yatharth1011/aegis-rescue-rover/team_share/engineering/AEGIS_Design_Calculations.md

# A.E.G.I.S. Design Calculations

Generated by `aegis_design_calcs.py`. Do not edit by hand. Change the inputs in the script and re-run it.

Source tags: **[L]** Robu.in listing (23-Oct-2026), **[D]** datasheet, **[G]** Fusion model geometry, **[A]** stated assumption.

## 1. Mass budget

| Item | Qty | g each | g total | Src |
|---|---:|---:|---:|---|
| Acrylic chassis plate 170x110x3 | 2 | 65.4 | 130.7 | G |
| PLA gripper base | 1 | 24.9 | 24.9 | G |
| PLA jaw (hub + arm) | 2 | 12.9 | 25.7 | G |
| N20 gearmotor with encoder | 4 | 11.0 | 44.0 | L |
| 44 mm wheel | 4 | 9.0 | 36.0 | A |
| MG946R servo | 1 | 65.0 | 65.0 | L |
| 3S1P 18650 pack incl. BMS, wrap, leads | 1 | 163.0 | 163.0 | A |
| ESP32-S3 DevKitC | 1 | 10.0 | 10.0 | A |
| ESP32-CAM + OV2640 | 1 | 10.0 | 10.0 | A |
| TB6612FNG module | 2 | 3.0 | 6.0 | A |
| XL4015 module with heatsink | 2 | 22.0 | 44.0 | A |
| MPU-6050 / INMP441 x2 / VL53L0X x3 | 1 | 13.0 | 13.0 | A |
| M3 pillars (20 F-F + 10 M-F) per corner | 4 | 4.5 | 18.0 | A |
| M3 screws, nuts | 1 | 20.0 | 20.0 | A |
| Wiring harness, perfboard, connectors | 1 | 60.0 | 60.0 | A |
| **Dry sum** | | | **670** | |
| Contingency 15 % | | | 101 | A |
| Design payload | | | 200 | A |
| **Design mass m** | | | **971** | |

## 2. Drive torque and traction

Per-wheel output torque, straight line:

$$\tau_{wheel} = \frac{r}{4}\left(C_{rr}\,m g\cos\theta + m a + m g\sin\theta\right)$$

Two corrections to the formula in the hand-off note:

- It used the traction coefficient μ as a resistive force. μ is the grip limit, not a drag. The drag term is rolling resistance $C_{rr}$. μ is used below only to check for wheel slip.
- It divided by a gearbox efficiency η. The listed motor torques are already measured at the gearbox output and the wheel is mounted directly on the shaft, so no extra η applies.

Skid-steer pivot turn: each wheel scrubs sideways at $\mu_{lat}\,mg/4$ with lever arm L/2. The four drive forces act at B/2:

$$F_{wheel} = \frac{\mu_{lat}\, m g\, L}{4B}, \qquad \tau_{wheel} = F_{wheel}\, r$$

| Input | Value | Src |
|---|---|---|
| Wheel radius r | 22.0 mm | G |
| Wheelbase L / track B | 110 / 132 mm | G |
| C_rr / μ traction / μ lateral | 0.05 / 0.8 / 0.6 | A |
| Design accel / incline | 0.5 m/s² / 15° | A |
| N20 rated torque (continuous limit) | 1.0 kg·cm = 0.0981 N·m @ 160 rpm | L |
| N20 stall: listed / derated | 7.0 / 2.8 kg·cm, 1.0 A | L / A |

| Load case | Total force | τ per wheel | % of rated | Check |
|---|---:|---:|---:|---|
| Cruise, flat, constant speed | 0.48 N | 0.027 kg·cm | 3 % | PASS |
| Accelerate 0.5 m/s² up 15° ramp | 3.41 N | 0.191 kg·cm | 19 % | PASS |
| Pivot turn in place | 1.19 N per wheel | 0.267 kg·cm | 27 % | PASS |

- Traction available per wheel: μ·mg/4 = 1.91 N. The worst drive force is 1.19 N per wheel, so the wheels grip and do not slip (PASS).
- The steepest climbable slope is set by traction, not torque: atan(μ) = 39°.
- Speed at rated load: 0.37 m/s. Pivot turning is the hardest drive case, at 1.4× the torque of the ramp case.

## 3. Electrical budget

Power architecture: the 3S pack (10.5–12.6 V) feeds both TB6612FNG drivers directly (VM max 15 V [D]). Two XL4015 bucks make separate 5.0 V rails: **Rail A** for logic and **Rail B** for the servo. The servo gets its own rail so its stall-current dips cannot trip the ESP32 brown-out reset.

### 3.1 Rail A, 5.0 V logic

| Load | Avg A | Peak A | Src |
|---|---:|---:|---|
| ESP32-S3 (Wi-Fi active, 240 MHz dual core) | 0.120 | 0.340 | D: ESP32-S3 TX peak ~340 mA |
| ESP32-CAM streaming OV2640 | 0.180 | 0.310 | A: ESP32 TX peak + camera |
| VL53L0X x3 (continuous ranging) | 0.057 | 0.057 | D: 19 mA active |
| MPU-6050 | 0.004 | 0.004 | D: 3.9 mA |
| INMP441 x2 | 0.003 | 0.003 | D: 1.4 mA |
| N20 Hall encoders x4 | 0.040 | 0.040 | A |
| TB6612FNG logic x2 | 0.004 | 0.004 | D |
| Module power LEDs (~6) | 0.030 | 0.030 | A |
| **Total** | **0.438** | **0.788** | |

XL4015 is rated 5 A. Rail A peaks at 16 % of that.

### 3.2 Rail B, 5.0 V servo

MG946R stall is listed at 1.2 A [L]. The rail is sized for 2.5 A [A], because MG99x-class servos commonly measure 2–2.5 A at stall. Measure the real value on a bench supply before trusting either number. The servo is run at 5.0 V, not 6 V, so its stall torque (10.9 kg·cm) keeps the printed gear above SF 2.5 (section 4).

### 3.3 Battery: worst case

Everything stalled at once, battery at 10.5 V loaded:

| Load | Battery-side A |
|---|---:|
| Motors 4 x stall | 4.00 |
| Servo stall (via buck) | 1.40 |
| Logic peak (via buck) | 0.44 |
| **Total** | **5.84** |

- C-rate: 5.84 A / 2.2 Ah = **2.66 C**, against the pack's 10 C rating (PASS).
- A 2C pack (the 999-rupee 2200 mAh INR option) has a 4.4 A limit and would **fail** this case. That is why the BOM uses the 10C ISR pack.
- The pack's BMS continuous rating is not on the listing. It must be ≥ 6 A. Check it on arrival.
- TB6612FNG channel: motor stall is 1.05 A at 12.6 V, against 1.2 A continuous per channel (PASS). This works only with **one motor per channel**, which is why the BOM has two drivers.

The hand-off note's figure was 4(0.45) + 1.2 + 0.25 + 0.1 = 3.35 A ("1.52 C, far below 20 C"). It was wrong in four ways:

1. It assumed 0.45 A motor stall. The listing says 1 A.
2. It assumed 1.2 A servo stall, the optimistic listing figure.
3. It added 5 V and 6 V rail currents directly to battery current, without converting through the buck converters.
4. It assumed the pack was rated 20 C. The pack it named is 2C.

### 3.4 Runtime, mission profile

Usable capacity: 2.2 Ah × 80 % = 1.76 Ah.

| Phase | Time share | Battery A (listed stall) | Battery A (derated stall) |
|---|---:|---:|---:|
| Cruise on flat at 0.3 m/s | 45 % | 0.51 | 0.53 |
| Pivot turns (acoustic homing) | 25 % | 0.54 | 0.67 |
| Ramp / obstacle climb 15 deg | 5 % | 0.65 | 0.81 |
| Stopped: listening / scanning | 20 % | 0.31 | 0.31 |
| Gripping | 5 % | 0.50 | 0.50 |
| **Time-weighted average** | | **0.49** | **0.53** |

- Runtime: **3.6 h** with the listed motor stall torque, **3.3 h** with it derated to 40 %.
- Runtime with everything continuously stalled: 18 min.
- Electronics dominate the average draw. The motors are lightly loaded except when pivot-turning.

## 4. Gripper strength (hand calculation, to be confirmed in Fusion Simulation)

Mechanism: the servo spline drives the +Y jaw directly. The −Y jaw pivots on an M3 steel pin. The two jaw hubs mesh as a 1:1 spur pair (module 2, 15 teeth, pitch radius 15 mm, face 10 mm), so each jaw sees the full servo torque.

Material: PLA+ printed flat (XY), allowable yield σ_y = 40 MPa [A]. Required SF ≥ 2.5.

Servo stall torque at 5.0 V: 10.92 kg·cm = 1.071 N·m (interpolated from listed 10.5 kg·cm @ 4.8 V and 13 kg·cm @ 6 V).

| Check | Load | Stress | SF | Result |
|---|---:|---:|---:|---|
| Jaw arm bending at hub, spec pinch | 10.0 N tip | 4.1 MPa | 9.8 | PASS |
| Jaw arm bending at hub, servo stall | 21.4 N tip | 8.8 MPa | 4.6 | PASS |
| Gear tooth (Lewis), servo stall | 71.4 N tangential | 12.3 MPa | 3.25 | PASS |
| Pivot bore bearing on PLA | 74.5 N | 2.5 MPa | 16.1 | PASS |

- Arm bending: σ = M/Z, with M = F·(L − r_hub) and Z = h·b²/6 (b = 8 mm in the bending direction, h = 8 mm).
- The **gear teeth are the critical feature**, not the jaw arm. A first layout used a 12-tooth, 12 mm-radius gear with the servo at 6 V. It gave σ = 18.4 MPa, SF = 2.18, a **fail**. The fix was to grow the pitch radius to 15 mm (15 teeth) and run the servo at 5.0 V.
- 15 teeth at 20° pressure angle is just under the 17-tooth undercut limit. Generate the teeth with Fusion's SpurGear add-in at 25° pressure angle, or with +0.1 profile shift.
- The torque needed for the 10 N spec pinch is 0.50 N·m, 47 % of stall. **Firmware must stop commanding the servo at the contact angle.** Commanding past contact stalls the servo continuously and heats it.

## 5. Fusion Simulation setup for the jaw (FEA)

Run this after `Build_AEGIS_Rover.py` and after cutting the real gear teeth.

1. **Simulation workspace → New Study → Static Stress.** Simplify: keep only the `Gripper_Jaw_PLA` body; remove or suppress everything else.
2. **Material:** Study Materials → PLA. If the library has no PLA, create a custom material: E = 3.5 GPa, ν = 0.36, ρ = 1.24 g/cm³, **yield = 40 MPa**, ultimate = 45 MPa.
3. **Constraints:**
   - Pin constraint on the 3.2 mm pivot bore (radial + axial fixed, tangential free).
   - Fixed constraint on the flank of one gear tooth at the pitch line. This reacts the drive torque the way the meshing tooth does.
4. **Loads:**
   - Case A: 10 N on the fingertip face, normal to it, pinching inward.
   - Case B: 21.4 N, the servo stall case.
5. **Mesh:** global 5 % of model size. Local mesh control 0.5 mm on the hub-to-arm junction and on the loaded tooth root. Enable adaptive refinement (3 passes).
6. **Pass criteria:**
   - Minimum safety factor (von Mises vs yield) ≥ 2.5 in both cases.
   - Peak stress in case B should be within about 30 % of the hand calculation: arm 8.8 MPa, tooth root 12.3 MPa.
   - If FEA is much higher at the hub-arm corner, add a 2 mm fillet there.
7. **Record for the report:** the safety-factor plot, the von Mises plot, the displacement at the fingertip, and the mesh convergence plot.
