yatharth1011/aegis-rescue-rover/.agents/rules/aegis-read-first.md

---
trigger: always_on
---

Before doing anything in this workspace, read `AGENTS.md` at the project root and follow it. It is mandatory.
Then read the matching skill in `.agents/skills/` for the task: firmware, brain/simulation, PDF guides, CAD/fabrication, office documents, or git.
Ask the user before any design change, deletion, history rewrite, or edit to the course submission files.
