yatharth1011/aegis-rescue-rover/team_share/edge/AEGIS_start_pad.pdf

rover outline (Mk2, 263 x 140 mm)

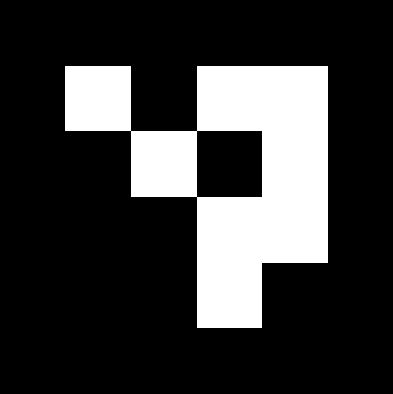
[picture p3: figure]

## FORWARD

100 mm: check with a ruler after printing

## A.E.G.I.S. start pad | ArUco DICT_4X4_50 id 0, 100 mm | print at 100 % (actual size)

Marker centre = --start x, y. Arrow = --start heading.
