yatharth1011/aegis-rescue-rover/FINAL/5_cad_model/render_iso_door_open.png

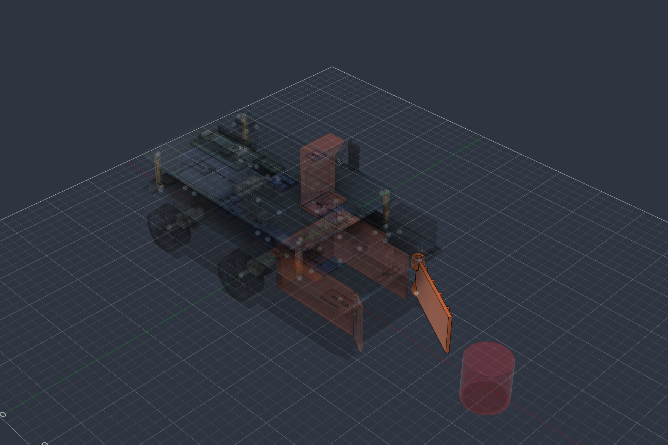
FINAL/5_cad_model/render_iso_door_open.png
