yatharth1011/aegis-rescue-rover/team_share/aegis_rl_training_curve.png

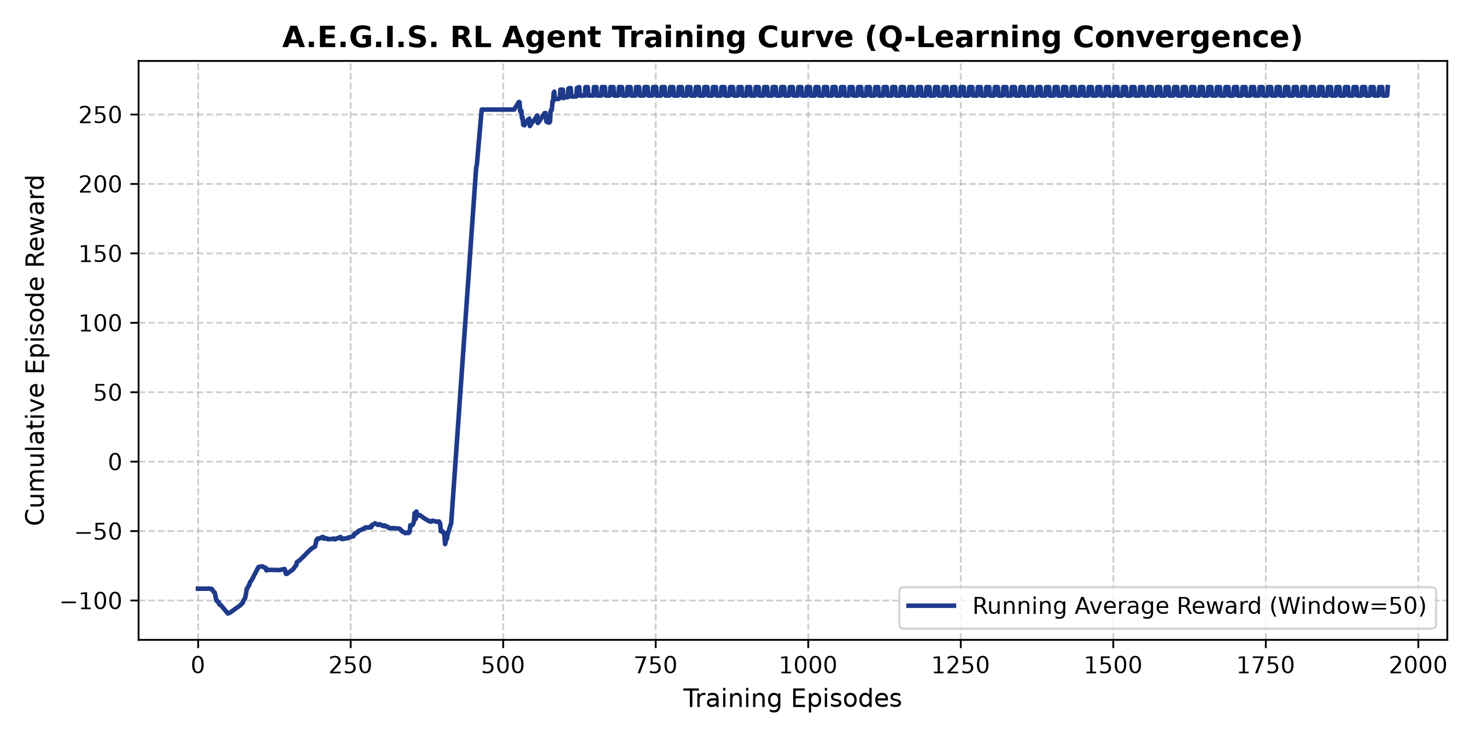
team_share/aegis_rl_training_curve.png
