yatharth1011/aegis-rescue-rover/team_share/deck_assets/ai_sees.png

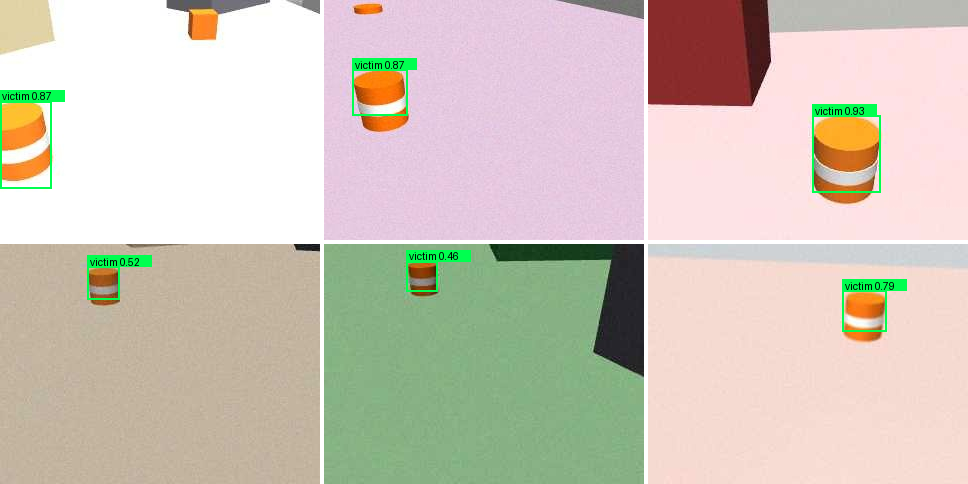
team_share/deck_assets/ai_sees.png
