yatharth1011/aegis-rescue-rover/team_share/deck_assets/demo2_poster.gif

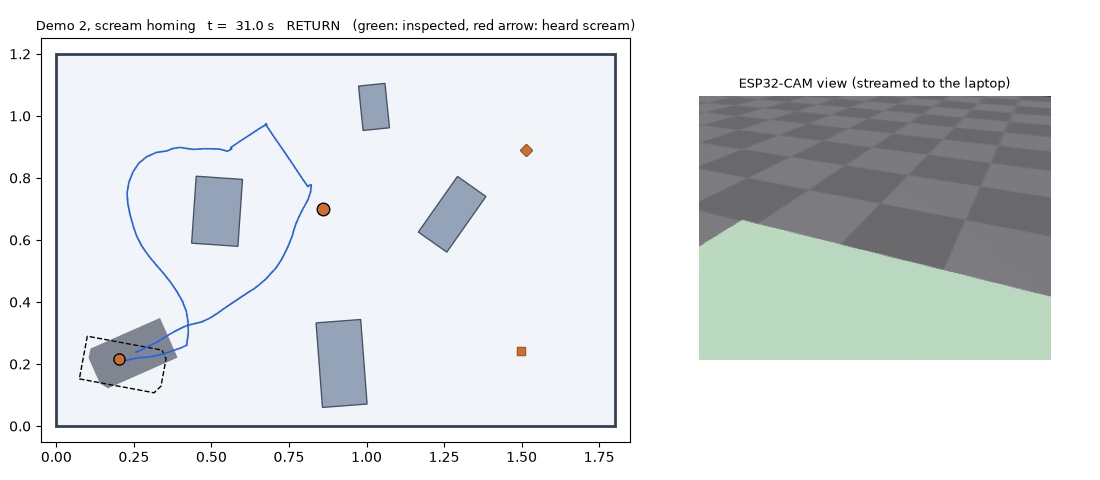
team_share/deck_assets/demo2_poster.gif
