yatharth1011/aegis-rescue-rover/team_share/deck_assets/render_iso_door_closed.png

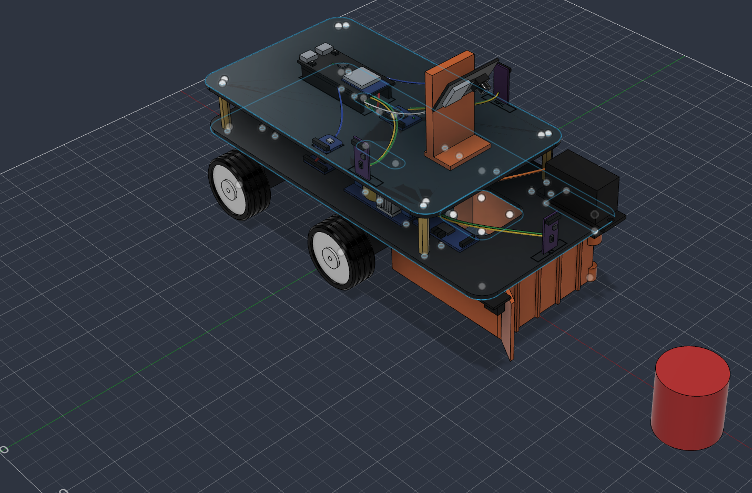
team_share/deck_assets/render_iso_door_closed.png
