yatharth1011/aegis-rescue-rover/team_share/deck_assets/render_iso_rear.png

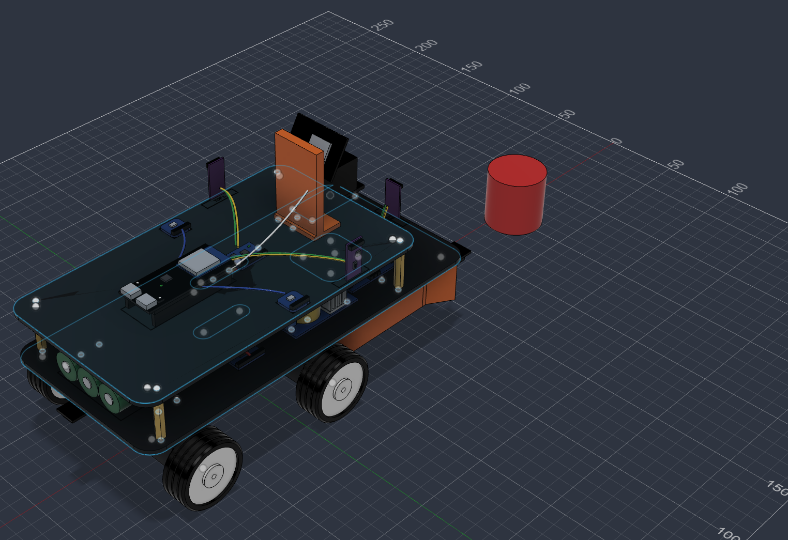
team_share/deck_assets/render_iso_rear.png
