yatharth1011/aegis-rescue-rover/team_share/deck_assets/render_side.png

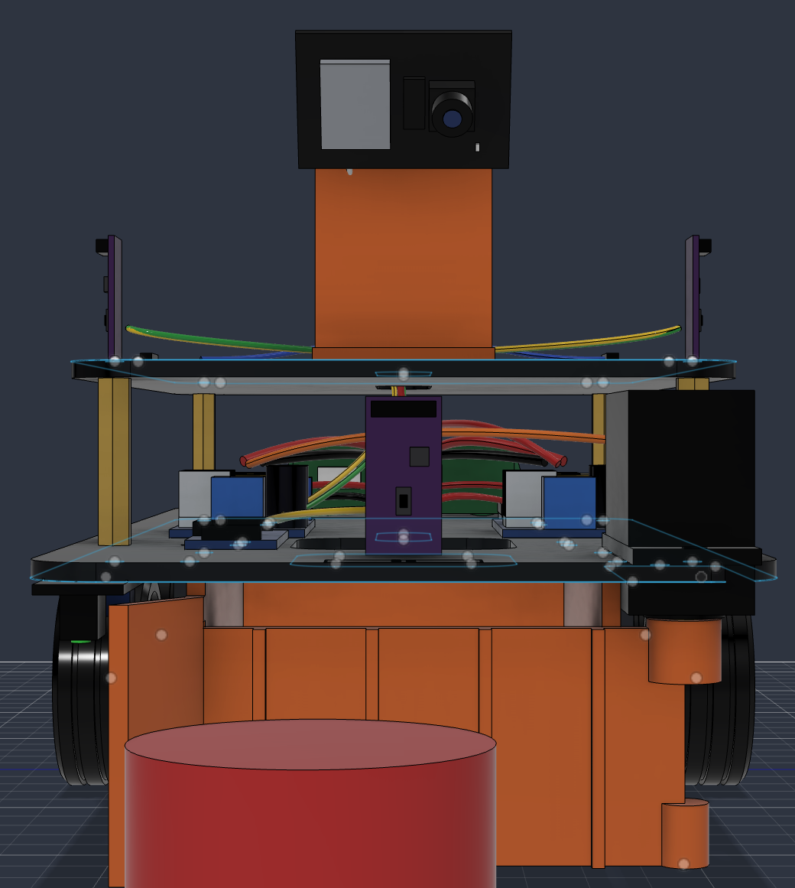
team_share/deck_assets/render_side.png
