yatharth1011/aegis-rescue-rover/FINAL/3_3d_print_K1_Max/AEGIS_plate1_black_PLA+_rover_parts.3mf

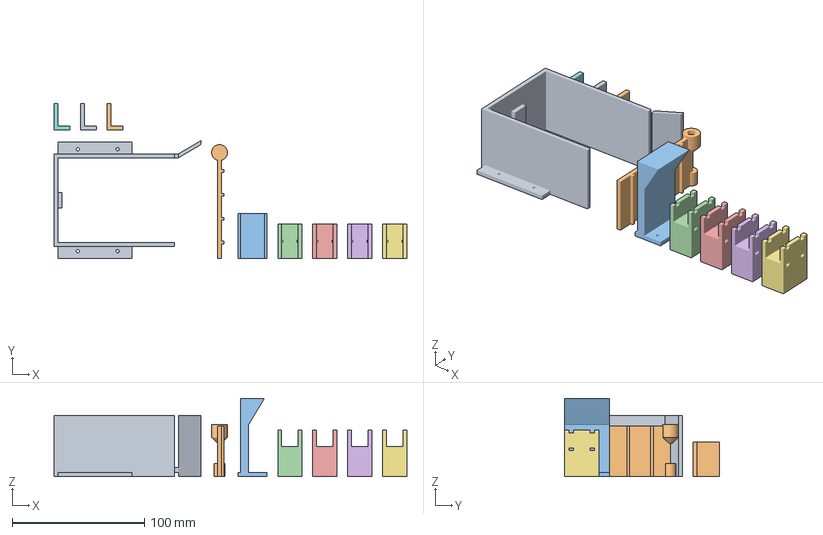
[picture p14: CAD file, 2026-10-26]
FINAL/3_3d_print_K1_Max/AEGIS_plate1_black_PLA+_rover_parts.3mf
266.6 x 117.0 x 59.0 mm
Intake_Shroud
Intake_Door
Camera_Mast
Motor_Hanger_1
Motor_Hanger_2
Motor_Hanger_3
Motor_Hanger_4
ToF_Bracket_Front
ToF_Bracket_Left
ToF_Bracket_Right
