yatharth1011/aegis-rescue-rover/team_share/Build_AEGIS_Rover/output/lasercad_lower_deck.dxf

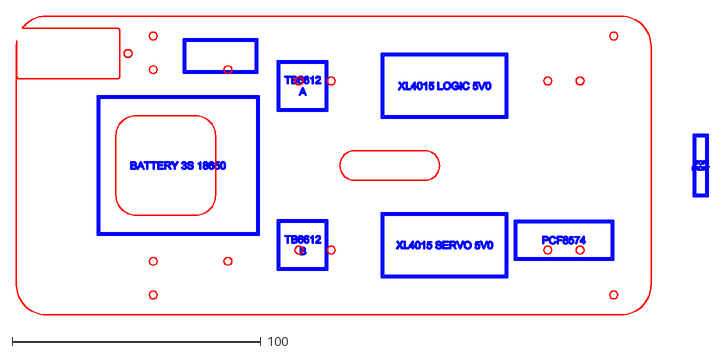
[picture p15: CAD file, 2026-10-25]
team_share/Build_AEGIS_Rover/output/lasercad_lower_deck.dxf
278.5 x 120.0
