yatharth1011/aegis-rescue-rover/team_share/Build_AEGIS_Rover/output_detailed/AEGIS_Rover_Detailed.step

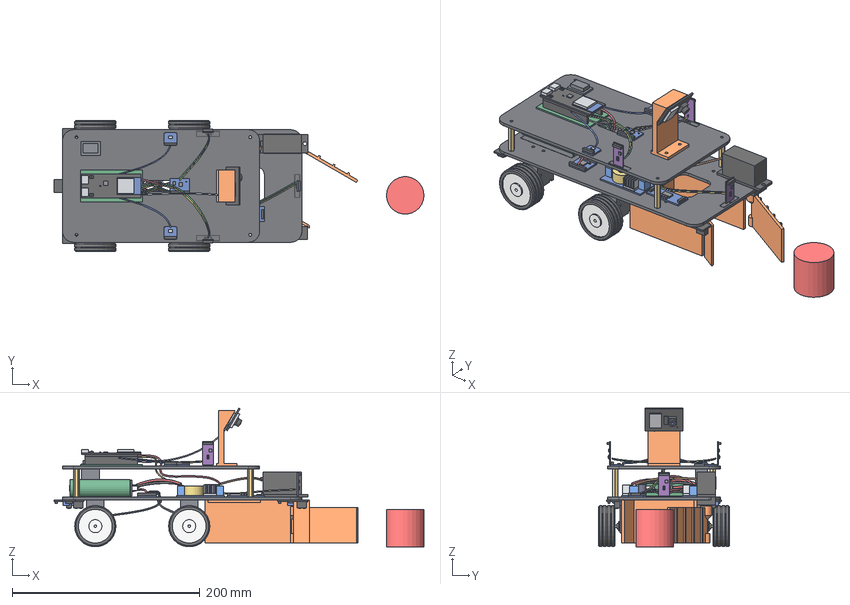
[picture p16: CAD file, 2026-10-25]
team_share/Build_AEGIS_Rover/output_detailed/AEGIS_Rover_Detailed.step
394.0 x 140.0 x 147.7 mm
