yatharth1011/aegis-rescue-rover/team_share/print/Camera_Mast.stl

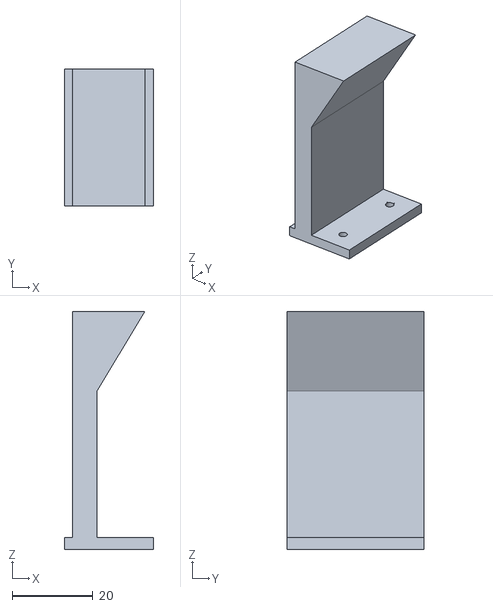
[picture p17: CAD file, 2026-10-26]
team_share/print/Camera_Mast.stl
22.0 x 34.0 x 59.0
