yatharth1011/aegis-rescue-rover/team_share/Build_AEGIS_Rover/output/lasercad_upper_deck.dxf

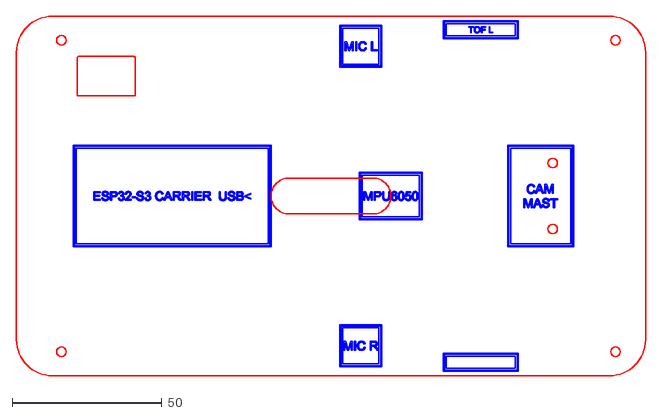
[picture p18: CAD file, 2026-10-25]
team_share/Build_AEGIS_Rover/output/lasercad_upper_deck.dxf
210.0 x 120.0
