yatharth1011/aegis-rescue-rover/team_share/Build_AEGIS_Rover/output_detailed/print_Intake_Door_PLA.stl

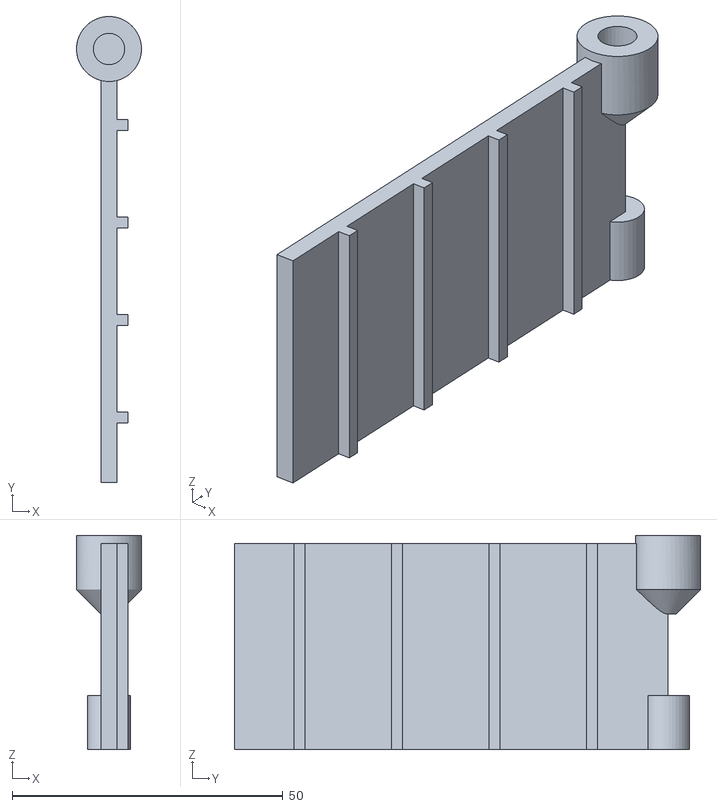
[picture p19: CAD file, 2026-10-25]
team_share/Build_AEGIS_Rover/output_detailed/print_Intake_Door_PLA.stl
12.0 x 86.0 x 39.5
