yatharth1011/aegis-rescue-rover/team_share/print/Intake_Shroud.stl

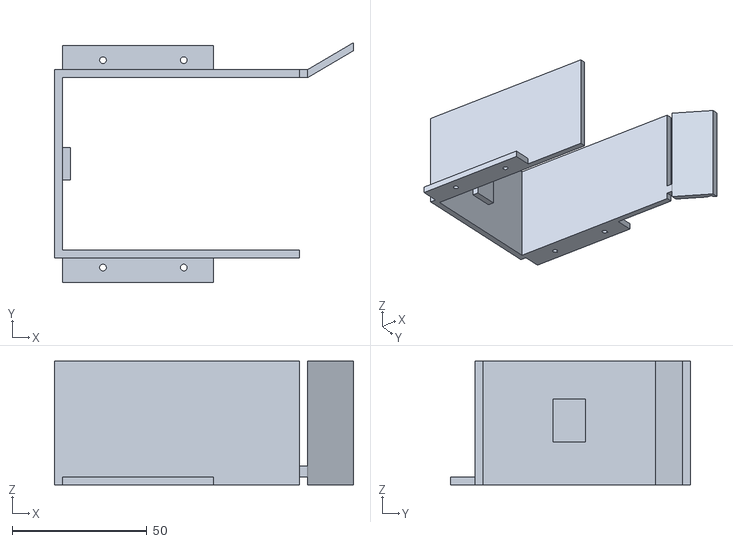
[picture p20: CAD file, 2026-10-26]
team_share/print/Intake_Shroud.stl
111.0 x 89.0 x 46.0
