yatharth1011/aegis-rescue-rover/team_share/Build_AEGIS_Rover/output/lasercad_lower_deck_underside.dxf

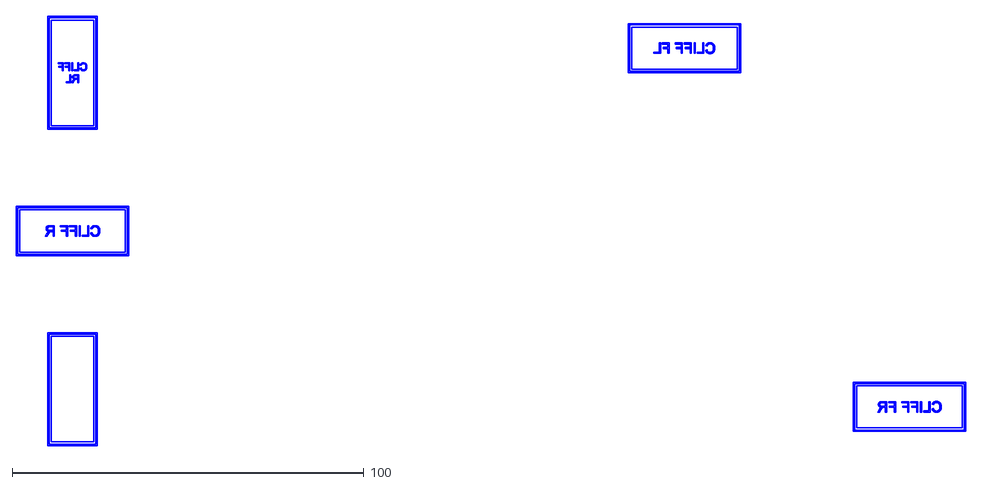
[picture p21: CAD file, 2026-10-25]
team_share/Build_AEGIS_Rover/output/lasercad_lower_deck_underside.dxf
270.0 x 122.0
