yatharth1011/aegis-rescue-rover/team_share/Build_AEGIS_Rover/output_detailed/lasercut_upper_deck.dxf

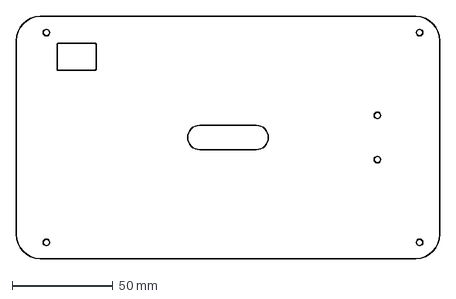
[picture p22: CAD file, 2026-10-25]
team_share/Build_AEGIS_Rover/output_detailed/lasercut_upper_deck.dxf
210.0 x 120.0 mm
