yatharth1011/aegis-rescue-rover/team_share/print/AEGIS_plate2_orange_PLA_demo_props.3mf

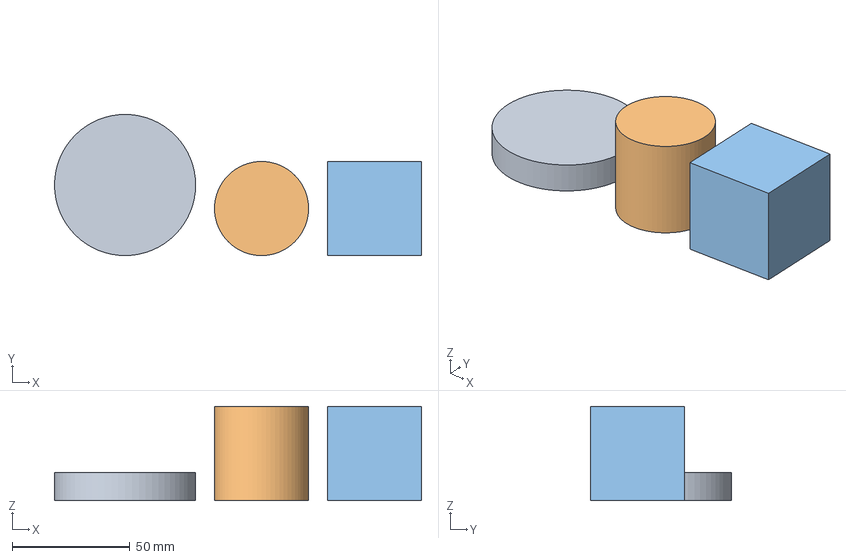
[picture p23: CAD file, 2026-10-26]
team_share/print/AEGIS_plate2_orange_PLA_demo_props.3mf
156.0 x 60.0 x 40.0 mm
Decoy_Disc_60mm
Victim_Token_40mm
Decoy_Cube_40mm
