yatharth1011/aegis-rescue-rover/team_share/Build_AEGIS_Rover/output/AEGIS_Rover.step

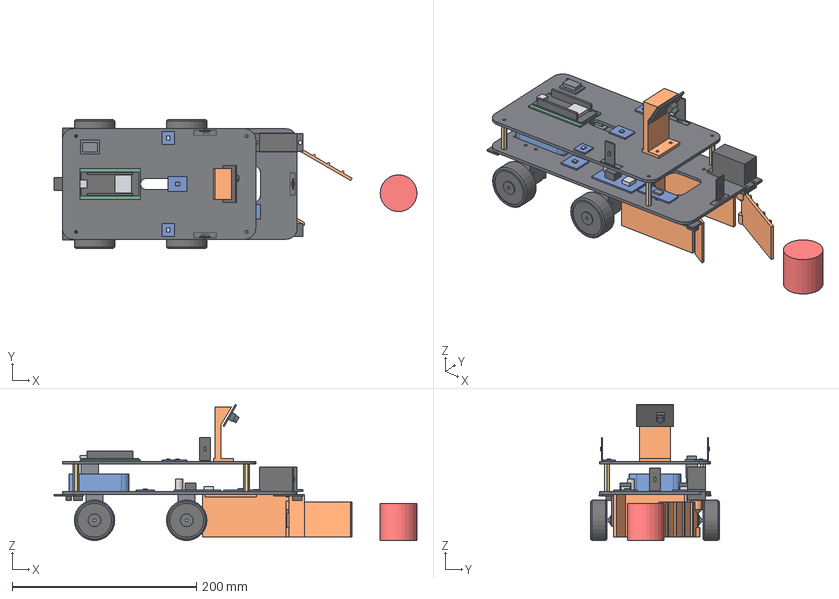
[picture p24: CAD file, 2026-10-25]
team_share/Build_AEGIS_Rover/output/AEGIS_Rover.step
394.0 x 140.0 x 147.7 mm
