yatharth1011/aegis-rescue-rover/team_share/Build_AEGIS_Rover/output_detailed/print_Motor_Hanger_PLA.stl

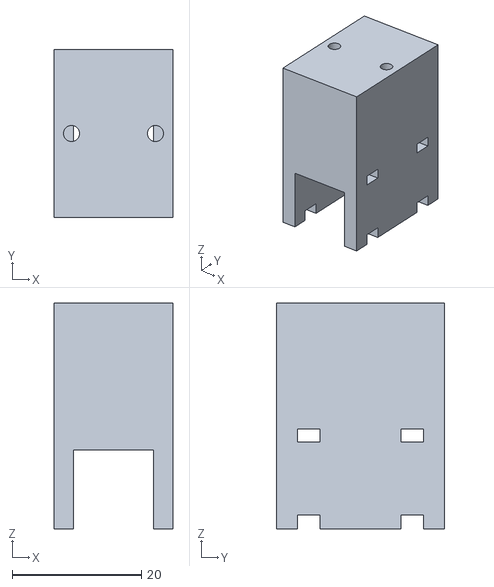
[picture p25: CAD file, 2026-10-25]
team_share/Build_AEGIS_Rover/output_detailed/print_Motor_Hanger_PLA.stl
18.4 x 26.0 x 35.0
