yatharth1011/aegis-rescue-rover/team_share/print/ToF_Bracket_Front.stl

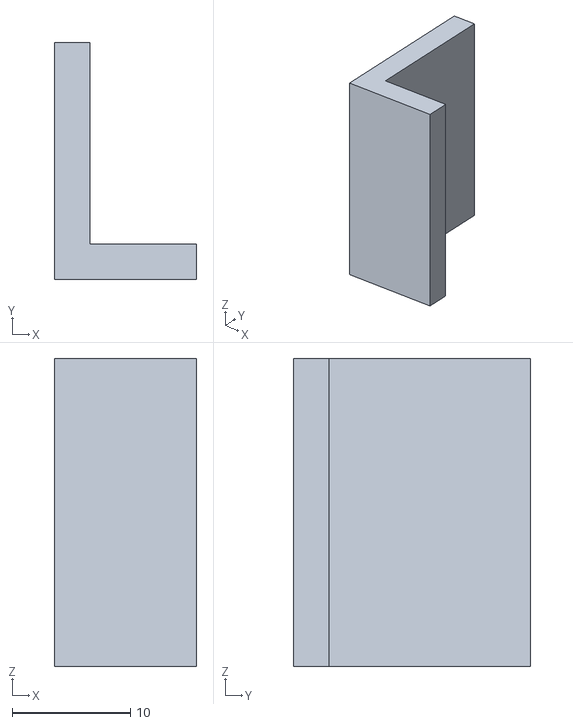
[picture p26: CAD file, 2026-10-25]
team_share/print/ToF_Bracket_Front.stl
12.0 x 20.0 x 26.0
