yatharth1011/aegis-rescue-rover/team_share/Build_AEGIS_Rover/output_detailed/engrave_lower_deck_top_labels.dxf

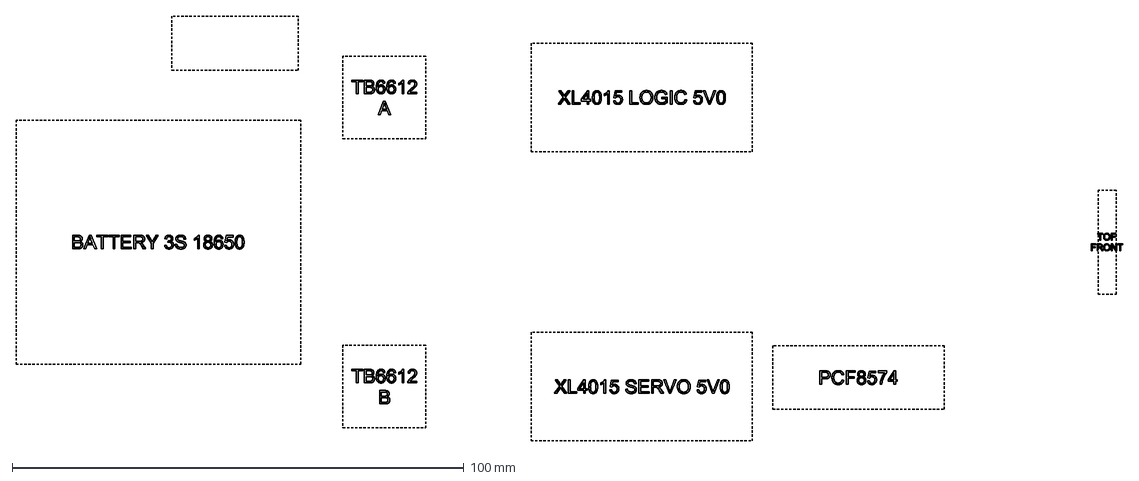
[picture p27: CAD file, 2026-10-25]
team_share/Build_AEGIS_Rover/output_detailed/engrave_lower_deck_top_labels.dxf
245.0 x 94.0 mm
