yatharth1011/aegis-rescue-rover/team_share/Build_AEGIS_Rover/output_detailed/engrave_lower_deck_underside.dxf

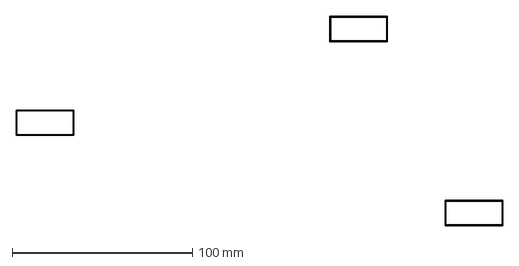
[picture p29: CAD file, 2026-10-24]
team_share/Build_AEGIS_Rover/output_detailed/engrave_lower_deck_underside.dxf
270.0 x 116.0 mm
