yatharth1011/aegis-rescue-rover/team_share/Build_AEGIS_Rover/output/engrave_upper_deck_top.dxf

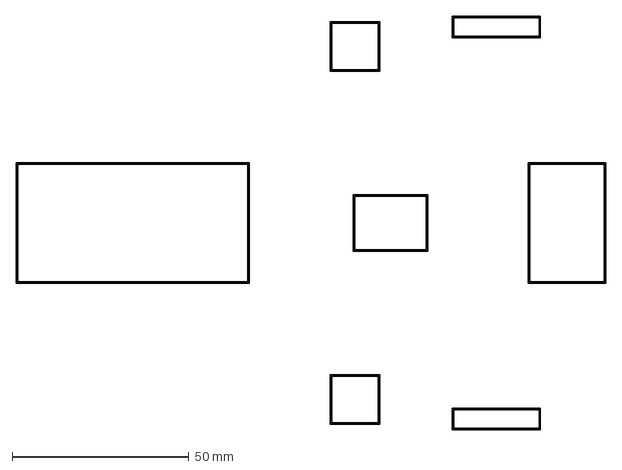
[picture p30: CAD file, 2026-10-25]
team_share/Build_AEGIS_Rover/output/engrave_upper_deck_top.dxf
167.0 x 117.0 mm
