yatharth1011/aegis-rescue-rover/team_share/Build_AEGIS_Rover/output_detailed/print_Camera_Mast_PLA.stl

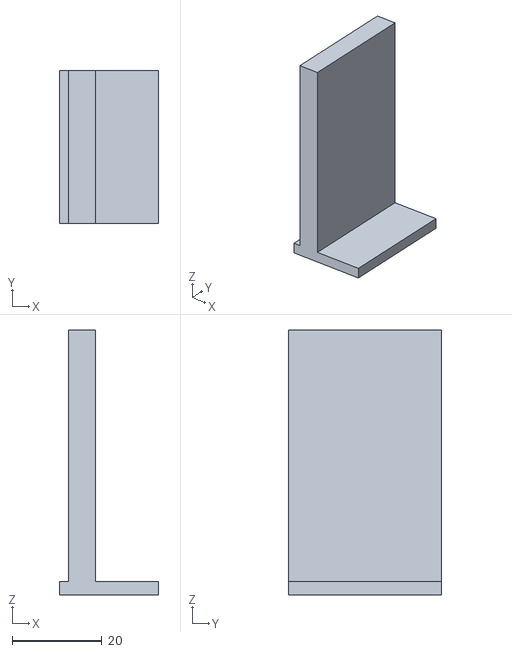
[picture p31: CAD file, 2026-10-24]
team_share/Build_AEGIS_Rover/output_detailed/print_Camera_Mast_PLA.stl
22.0 x 34.0 x 59.0
