yatharth1011/aegis-rescue-rover/team_share/Build_AEGIS_Rover/output/engrave_upper_deck_top_labels.dxf

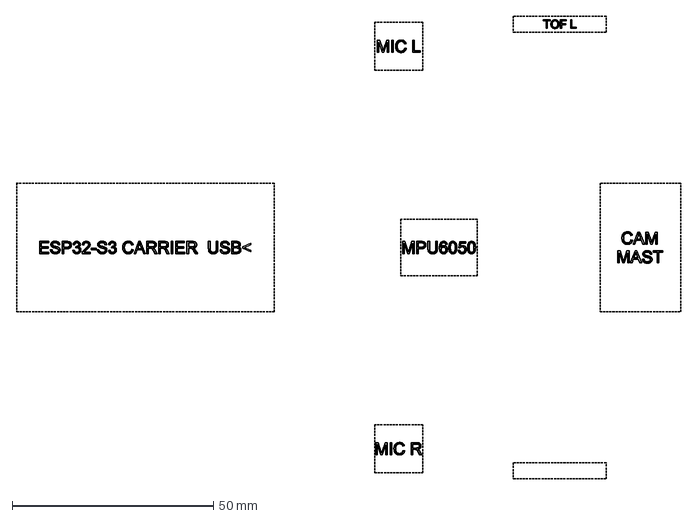
[picture p32: CAD file, 2026-10-25]
team_share/Build_AEGIS_Rover/output/engrave_upper_deck_top_labels.dxf
165.0 x 115.0 mm
