yatharth1011/aegis-rescue-rover/team_share/Build_AEGIS_Rover/output_detailed/engrave_lower_deck_underside_labels.dxf

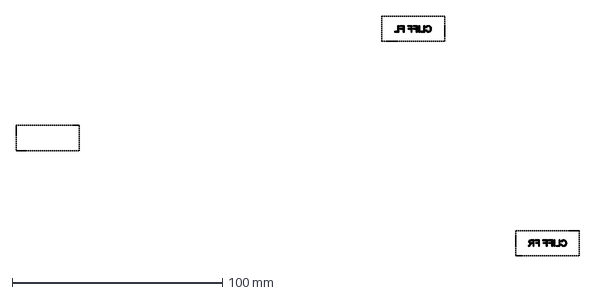
[picture p33: CAD file, 2026-10-24]
team_share/Build_AEGIS_Rover/output_detailed/engrave_lower_deck_underside_labels.dxf
268.0 x 114.0 mm
