yatharth1011/aegis-rescue-rover/team_share/print/AEGIS_PLA_parts.3mf

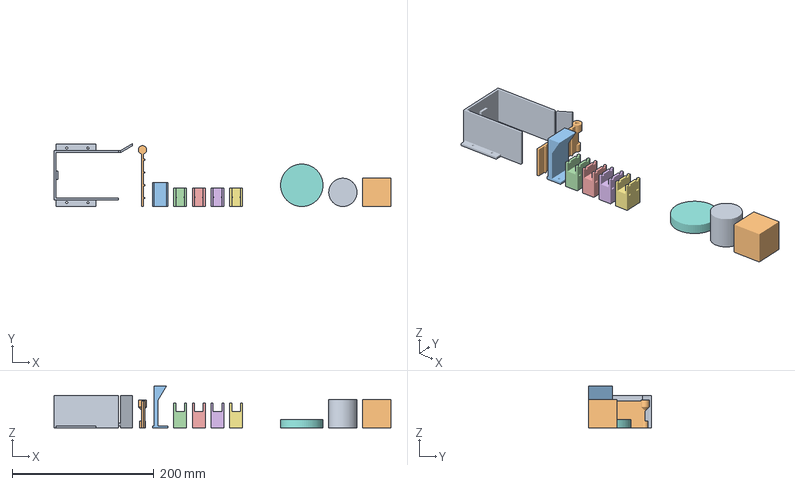
[picture p34: CAD file, 2026-10-25]
team_share/print/AEGIS_PLA_parts.3mf
476.0 x 89.0 x 59.0 mm
Intake_Shroud
Intake_Door
Camera_Mast
Motor_Hanger_1
Motor_Hanger_2
Motor_Hanger_3
Motor_Hanger_4
Decoy_Disc_60mm
Victim_Token_40mm
Decoy_Cube_40mm
