yatharth1011/aegis-rescue-rover/team_share/Build_AEGIS_Rover/output/engrave_lower_deck_top.dxf

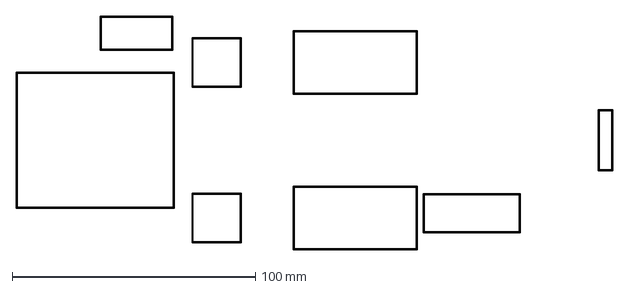
[picture p35: CAD file, 2026-10-25]
team_share/Build_AEGIS_Rover/output/engrave_lower_deck_top.dxf
245.5 x 96.0 mm
