yatharth1011/aegis-rescue-rover/team_share/Build_AEGIS_Rover/output_detailed/engrave_upper_deck_top.dxf

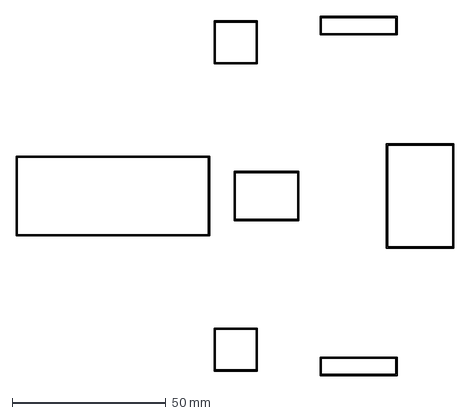
[picture p36: CAD file, 2026-10-24]
team_share/Build_AEGIS_Rover/output_detailed/engrave_upper_deck_top.dxf
142.5 x 117.0 mm
