yatharth1011/aegis-rescue-rover/team_share/print/Decoy_Cube_40mm.stl

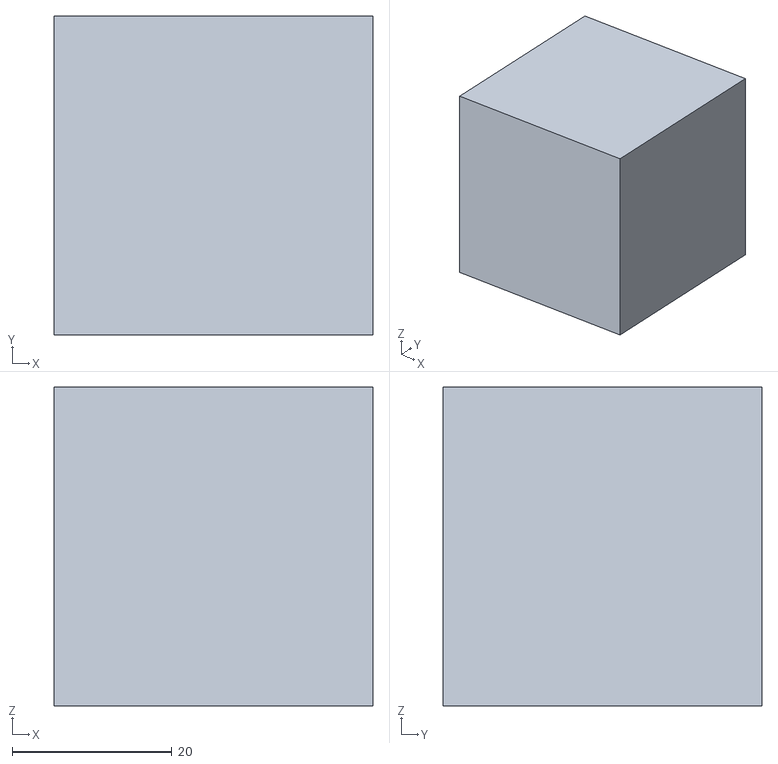
[picture p37: CAD file, 2026-10-25]
team_share/print/Decoy_Cube_40mm.stl
40.0 x 40.0 x 40.0
