yatharth1011/aegis-rescue-rover/team_share/print/Victim_Token_40mm.stl

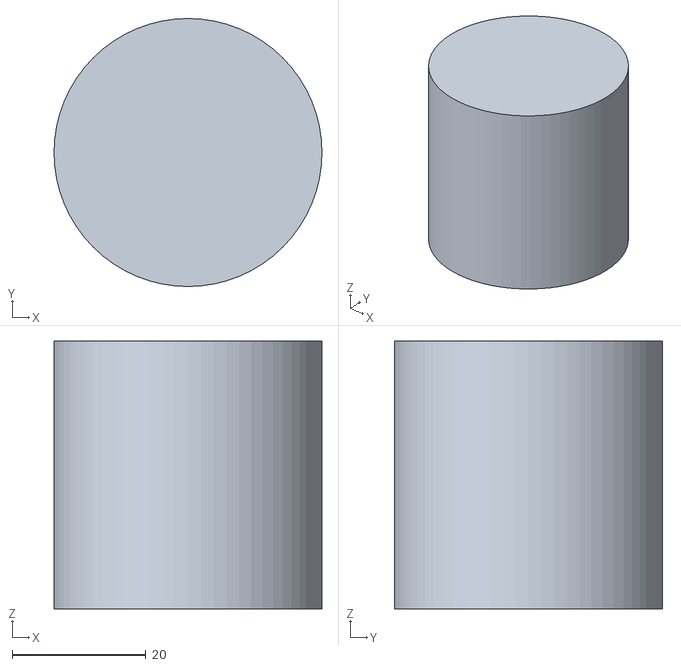
[picture p38: CAD file, 2026-10-25]
team_share/print/Victim_Token_40mm.stl
40.0 x 40.0 x 40.0
