yatharth1011/aegis-rescue-rover/team_share/print/Decoy_Disc_60mm.stl

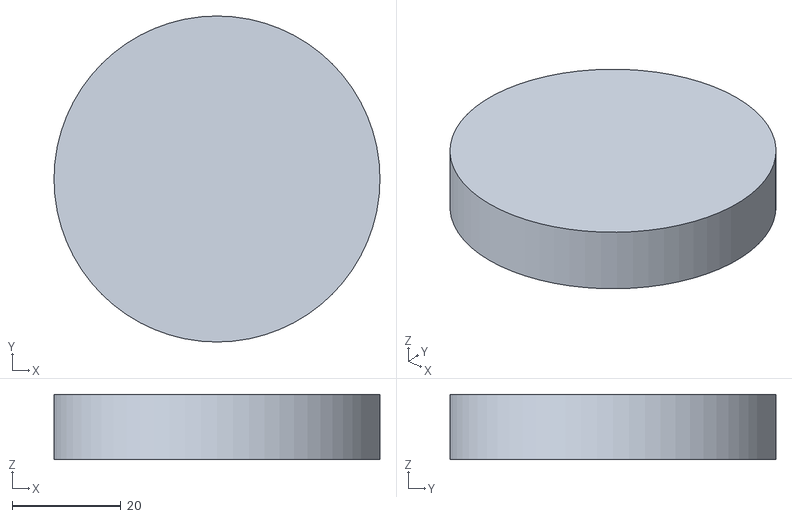
[picture p40: CAD file, 2026-10-25]
team_share/print/Decoy_Disc_60mm.stl
60.0 x 60.0 x 12.0
