yatharth1011/aegis-rescue-rover/team_share/Build_AEGIS_Rover/output/engrave_lower_deck_underside_labels.dxf

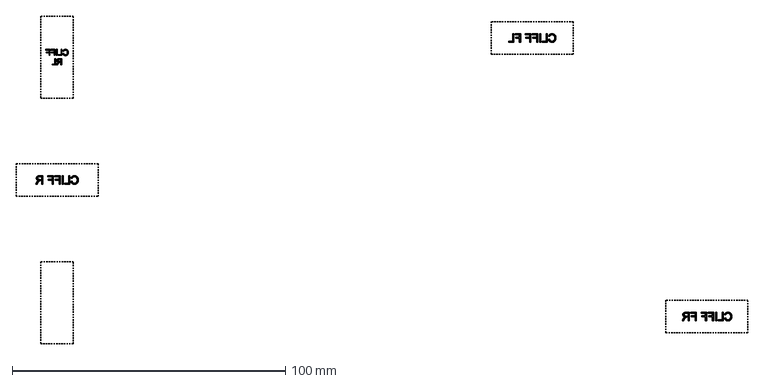
[picture p41: CAD file, 2026-10-24]
team_share/Build_AEGIS_Rover/output/engrave_lower_deck_underside_labels.dxf
268.0 x 120.0 mm
