yatharth1011/aegis-rescue-rover/team_share/Build_AEGIS_Rover/output/engrave_lower_deck_top_labels.dxf

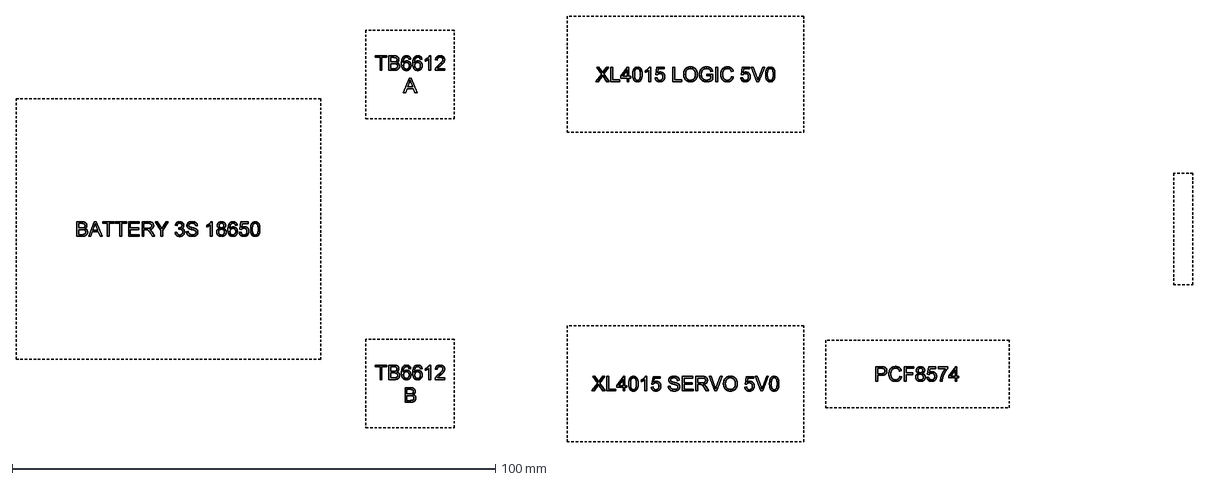
[picture p42: CAD file, 2026-10-24]
team_share/Build_AEGIS_Rover/output/engrave_lower_deck_top_labels.dxf
243.5 x 88.0 mm
