yatharth1011/aegis-rescue-rover/team_share/Build_AEGIS_Rover/output/lasercut_lower_deck.dxf

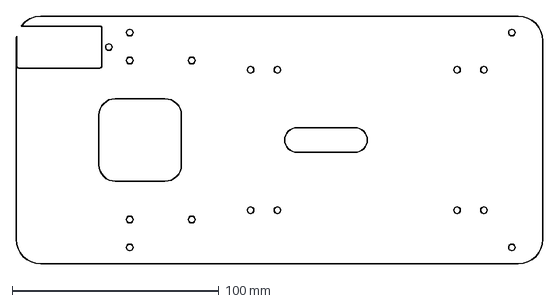
[picture p43: CAD file, 2026-10-24]
team_share/Build_AEGIS_Rover/output/lasercut_lower_deck.dxf
255.0 x 120.0 mm
