yatharth1011/aegis-rescue-rover/team_share/Build_AEGIS_Rover/output/print_Motor_Hanger_PLA.stl

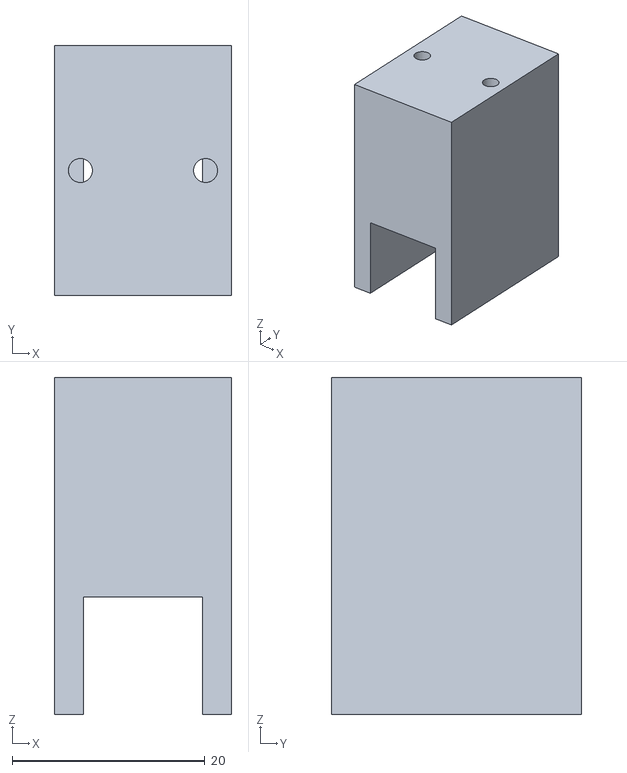
[picture p44: CAD file, 2026-10-24]
team_share/Build_AEGIS_Rover/output/print_Motor_Hanger_PLA.stl
18.4 x 26.0 x 35.0
