yatharth1011/aegis-rescue-rover/(list of files, cad)

Other CAD files:
team_share/Build_AEGIS_Rover/output/print_Intake_Shroud_PLA.stl
team_share/print/AEGIS_plate1_black_PLA+_rover_parts.3mf
team_share/print/Intake_Door.stl
team_share/print/Motor_Hanger_3.stl
team_share/Build_AEGIS_Rover/output/print_Camera_Mast_PLA.stl
AEGIS Body.f3d
AEGIS Detailed Final.f3d
AEGIS Detailed.f3d
AEGIS Final.f3d
FINAL/5_cad_model/AEGIS_Rover.f3d
FINAL/5_cad_model/AEGIS_Rover_Detailed.f3d
The Most Final AEGIS Body Detailed.f3d
The Most Final AEGIS Body.f3d
team_share/Build_AEGIS_Rover/output/AEGIS_Rover.f3d
team_share/Build_AEGIS_Rover/output_detailed/AEGIS_Rover_Detailed.f3d
