yatharth1011/aegis-rescue-rover/team_share/AEGIS_Wiring_Guide.pdf

## A.E.G.I.S. wiring guide 1/3: ESP32-S3-DevKitC-1 pin assignment (top view, antenna up)

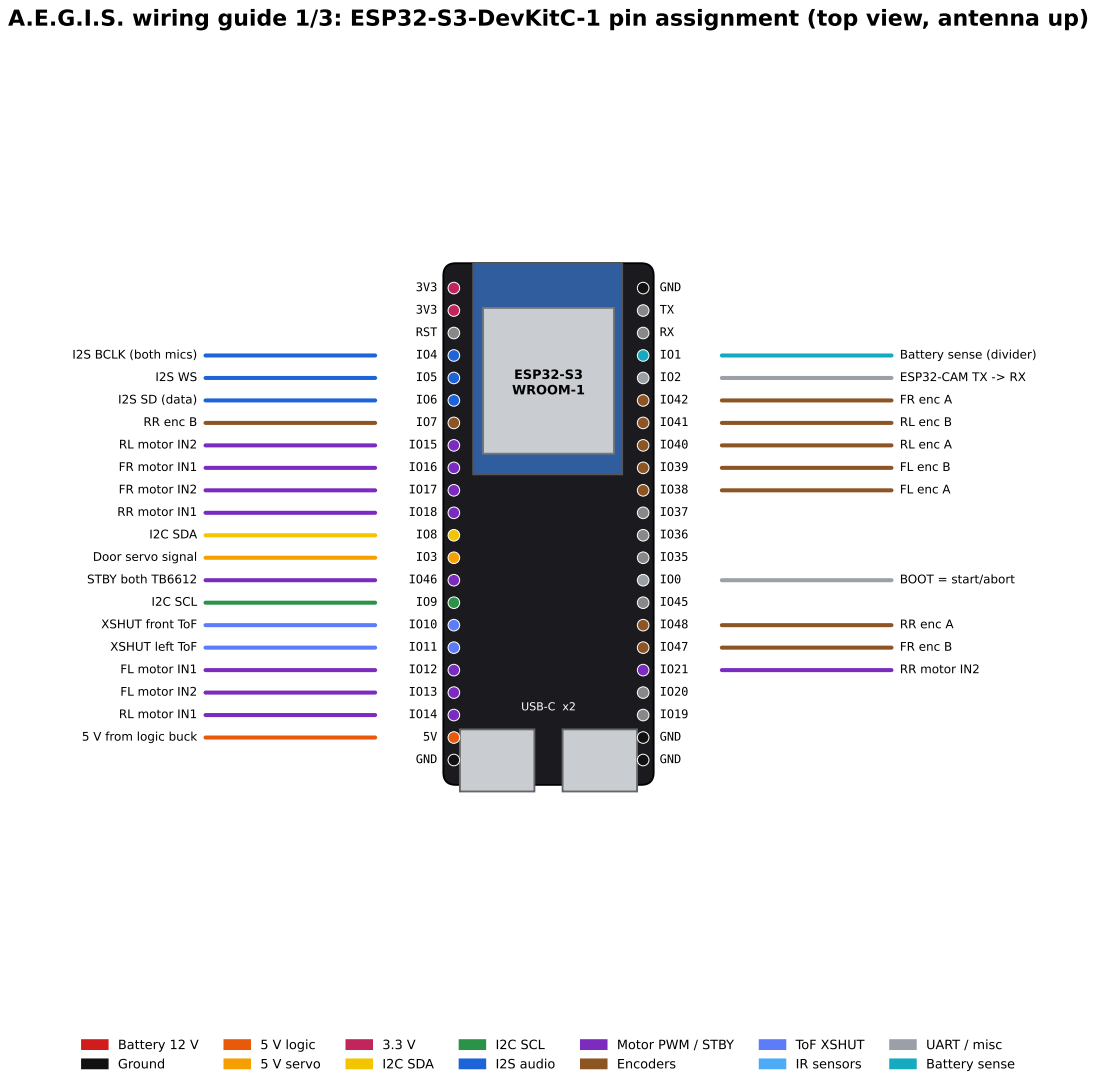
[picture p83: page 1]
ESP32-S3 WROOM-1; USB-C x2; 3V3 3V3 RST; I2S BCLK (both mics); I2S SD (data); RR enc B; RL motor IN2; FR motor IN1; FR motor IN2; RR motor IN1; I2C SDA; Door servo signal; STBY both TB6612; I2C SCL; XSHUT front ToF; XSHUT left ToF; FL motor IN1; FL motor IN2; RL motor IN1; 5 V from logic buck; GND; GND TX RX; Battery sense (divider); ESP32-CAM TX -> RX; FR enc A; RL enc B; RL enc A; FL enc B; FL enc A; BOOT = start/abort; RR enc A; FR enc B; RR motor IN2; IO20 IO19 GND GND; Battery 12 V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

Motor PWM / STBY
Encoders

20.3 x 20.3 mm Battery + ⁽¹⁰.5⁻12.6 V⁾ VM 3V3 VCC GND GND front motor + AO¹ front motor ⁻ AO² rear motor ⁻ BO² rear motor + BO¹ GND GND PWMA tie to 3V3 AIN² IN² ⁽GPIO ¹³/17⁾ AIN¹ IN¹ ⁽GPIO ¹²/16⁾ STBY GPIO ⁴⁶ BIN¹ IN¹ ⁽GPIO ¹⁴/18⁾ BIN² IN² ⁽GPIO ¹⁵/21⁾ PWMB tie to 3V3 GND GND

TB6612FNG (x2: A = left wheels, B = right)

Battery + IN+

Battery - IN- | 51 x 26 mm | OUT+ 5.0 V out (set BEFORE load) OUT- GND

XL4015 buck (x2: logic 5.0 V, servo 5.0 V)

25 x 12 mm

3V3 VIN
GND GND
I2C SCL SCL
I2C SDA SDA
not used GPIO1
GPIO 10 / 11 / tie high (right) XSHUT

GY-530 VL53L0X (x3: front, left, right)

# 21 x 16 mm 3V3 VCC GND GND I2C SCL SCL I2C SDA SDA - XDA - XCL GND ⁽addr 0x68⁾ AD⁰ - INT

GY-521 MPU-6050

# 14 x 14 mm L: GND / R: 3V3 L/R GPIO ⁵ WS GPIO ⁴ SCK GPIO ⁶ SD 3V3 VDD GND GND

INMP441 mic (x2)

40 x 16 mm

GND GND
3V3 VCC
I2C SDA SDA
I2C SCL SCL

## cliff FL P0

## cliff FR P1 cliff rear P2

## cliff RL P3

## cliff RR P4

bay capture P5

PCF8574T I/O expander

32 x 14 mm

3V3 VCC
GND GND
PCF8574 P0-P5 DO

TCRT5000 x5 / IR obstacle module x1

40.7 x 19.7 mm

GND brown
servo buck 5.0 V red
GPIO 3 orange

red M+ to AO1/BO1
white M- to AO2/BO2
black encoder VCC 3V3
blue encoder GND
yellow enc A
green enc B
MG946R servo | N20 encoder motor (x4)

A.E.G.I.S. wiring guide 2/3: module faces, pins and where each wire lands (top views, to scale)

Battery 12 V
Ground

5 V logic
5 V servo

3.3 V
I2C SDA

I2C SCL
I2S audio

Motor PWM / STBY
Encoders

ToF XSHUT
IR sensors

UART / misc
Battery sense

From | To | Signal | Wire
Battery + (T-connector lead) | 6.3 A fuse, power switch, then both XL4015 IN+ and both TB6612 VM | 10.5-12.6 V | 18 AWG
Battery - | Both XL4015 IN-, all GND | 0 V | 18 AWG
XL4015 logic OUT+ | ESP32-S3 5V, ESP32-CAM 5V | 5.0 V | 22 AWG
XL4015 servo OUT+ | MG946R red | 5.0 V | 22 AWG
ESP32-S3 3V3 | sensors VCC, TB6612 VCC + PWMA/PWMB, encoders | 3.3 V | 26 AWG
ESP32 GPIO 8 / 9 | VL53L0X x3, MPU-6050, PCF8574 (SDA/SCL), 2.2 k pull-ups | I2C 400 kHz | 26 AWG
ESP32 GPIO 4 / 5 / 6 | both INMP441 SCK / WS / SD | I2S 48 kHz | 26 AWG, short
ESP32 GPIO 10 / 11 | front / left VL53L0X XSHUT (right: tie to VIN) | address select | 26 AWG
ESP32 GPIO 12-18, 21 | TB6612 AIN1/AIN2/BIN1/BIN2 | 20 kHz PWM | 26 AWG
ESP32 GPIO 46 | STBY on both TB6612 | enable | 26 AWG
TB6612 AO1/AO2/BO1/BO2 | motor red / white | motor power | 22 AWG
Encoders yellow / green | GPIO 38/39, 40/41, 42/47, 48/7 | quadrature | 26 AWG
ESP32 GPIO 3 | MG946R orange | 50 Hz servo pulse | 26 AWG
ESP32-CAM U0T | ESP32 GPIO 2 | UART 115200 | 26 AWG
Battery + via 100k / 20k | ESP32 GPIO 1 (divider tapped after the switch) | battery voltage | 26 AWG
IR modules DO | PCF8574 P0-P5 | 5 cliff + bay capture | 26 AWG

The fuse and the power switch sit in the battery + line before anything else. The 2.2 k pull-ups and the battery divider are on the ESP32-S3 carrier board.
Common ground star point at the battery negative. Set both XL4015 outputs to 5.0 V with a meter before connecting any board. Twist each motor's two leads together. Keep the I2S wires short (< 15 cm).
Header orders follow the reference boards; clone modules sometimes differ: check the silkscreen before soldering.

## A.E.G.I.S. wiring guide 3/3: wire list
