yatharth1011/aegis-rescue-rover/FINAL/4_guides/AEGIS_Wiring_Guide.pdf

## A . E . G . I . S . M K 2

# Wiring guide

## 15 steps, each with its own drawing and a check. Wire as you assemble, in this order:

Solder headers on the modules, build the ESP32-S3 carrier, the fuse board, the switch leads and the power bus (W1-W3). Easier

ASSEMBLY 1-15 | Motors, wheels, edge sensors, intake bay, battery, lower-deck boards (Assembly guide).
STEP 16: WIRE | Lower deck: power, set 5.0 V, motors, servo power, IR sensors, then label the leads for the upper deck (W4-W9).
ASSEMBLY 17-23 | Pillars, upper deck, switch, carrier with the ESP32-S3 removed, gyro, mics, side sensors.
STEP 24: WIRE | Upper deck: power, I2C, microphones, motor control, encoders and servo signal (W10-W14).
POWER-UP | First power-up checks (W15), then assembly 25-27 and the Deployment guide.

A.E.G.I.S. Mk2 | Wiring guide | page 2 of 20

# Rules for every wire

1. Battery unplugged whenever you solder or move a wire.

## 2. Cut each wire 3 cm longer than the route, strip 5 mm, twist the strands, tin

them.
3. Slide heat-shrink on before soldering; shrink it over every power joint.
4. Tug test: pull each finished joint gently. It must not move.

## 5. Red = plus, black = ground, always. Signal wires: white or green, flagged with

masking tape.
6. One row of the table at a time; tick it off on a printed copy.
7. Never connect a regulator output before it reads 5.0 V (W5).
Wire | Use
18 AWG red / black | battery, fuse, switch, power bus, regulator and driver inputs
22 AWG 3-core | 5 V outputs, servo power, motor M1 / M2
26 AWG red / black | 3.3 V and ground to sensors
26 AWG white / green | all signals

### Pin numbers match the firmware (aegis_config.h). The reference pages at the end show

every board face and the full pin map. Clone boards sometimes order their pins differently: always read the label printed on the board.

W1 Before assembly: solder headers on the modules | Bench, before assembly

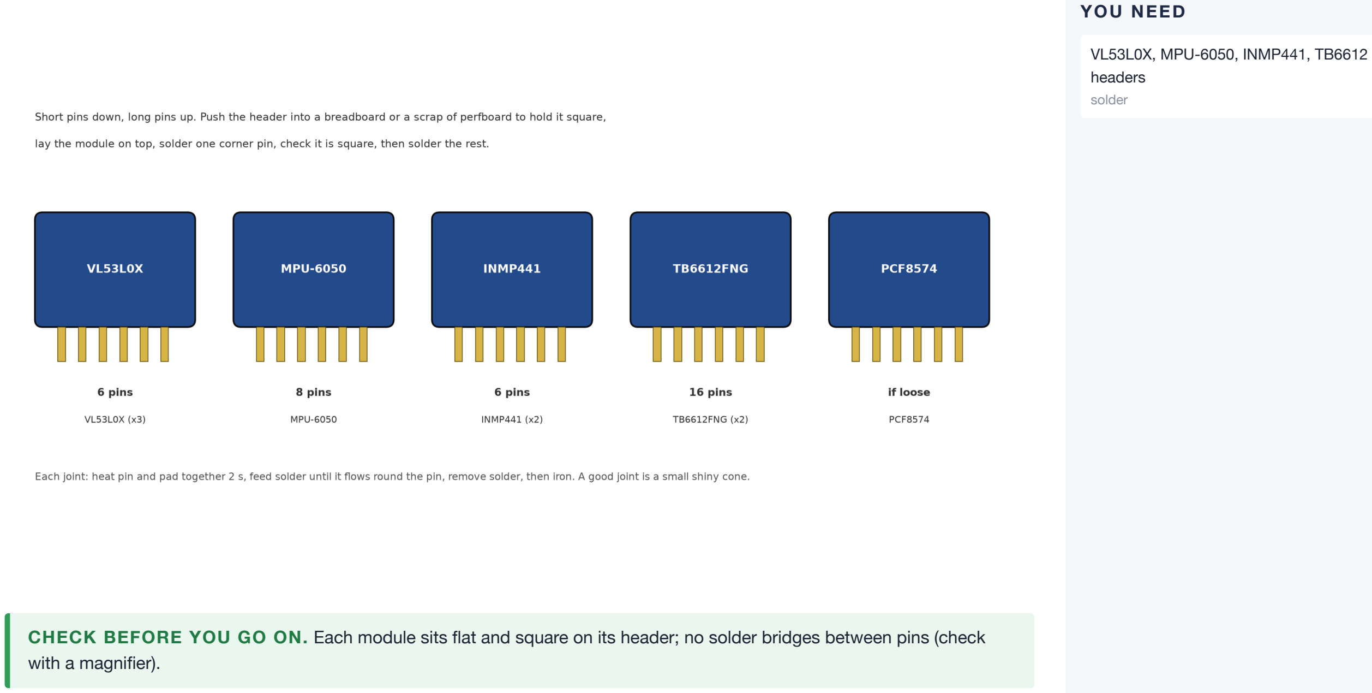
[picture p92: figure]
YOU NEED; VL53L0X, MPU-6050, INMP441, TB6612 headers; solder; with a magnifier).

CHECK BEFORE YOU GO ON. Each module sits flat and square on its header; no solder bridges between pins (check

W2 Before assembly: build the ESP32-S3 carrier board | Bench, before assembly

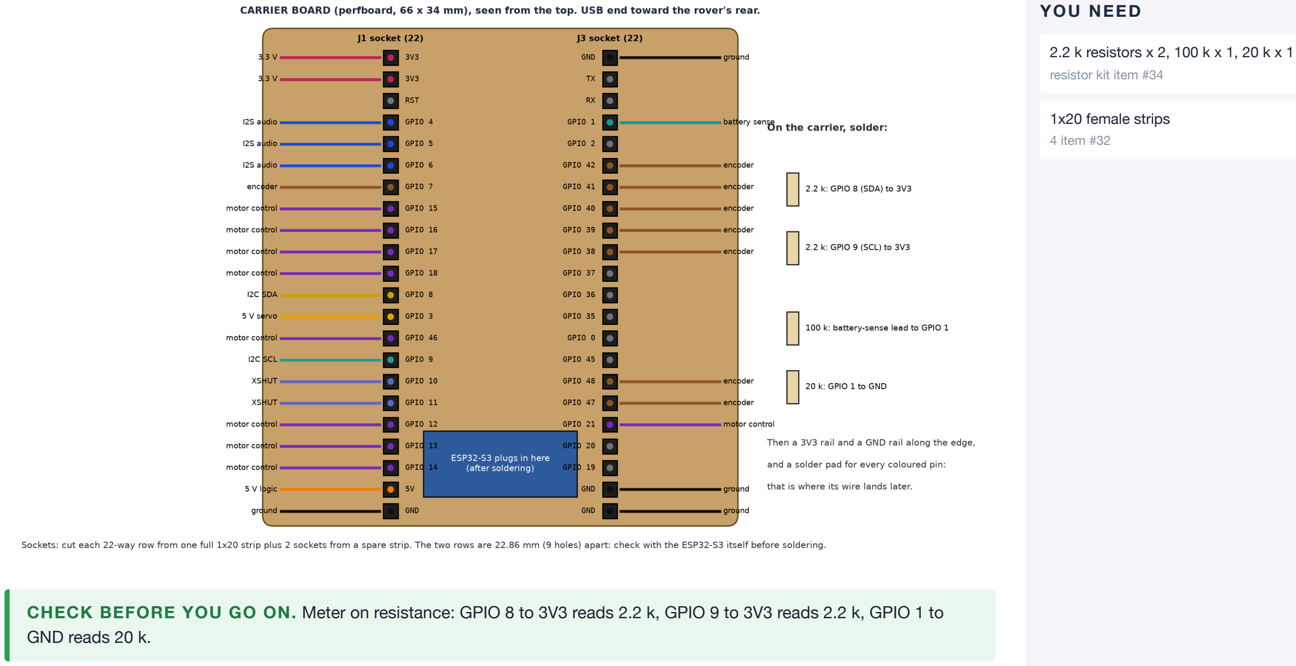
[picture p93: figure]
YOU NEED; resistor kit item #34; 1x20 female strips; 4 item #32; GND reads 20 k.

2.2 k resistors x 2, 100 k x 1, 20 k x 1

CHECK BEFORE YOU GO ON. Meter on resistance: GPIO 8 to 3V3 reads 2.2 k, GPIO 9 to 3V3 reads 2.2 k, GPIO 1 to

W3 Before assembly: battery lead, fuse, switch, power bus | Bench, before assembly

## YOU NEED

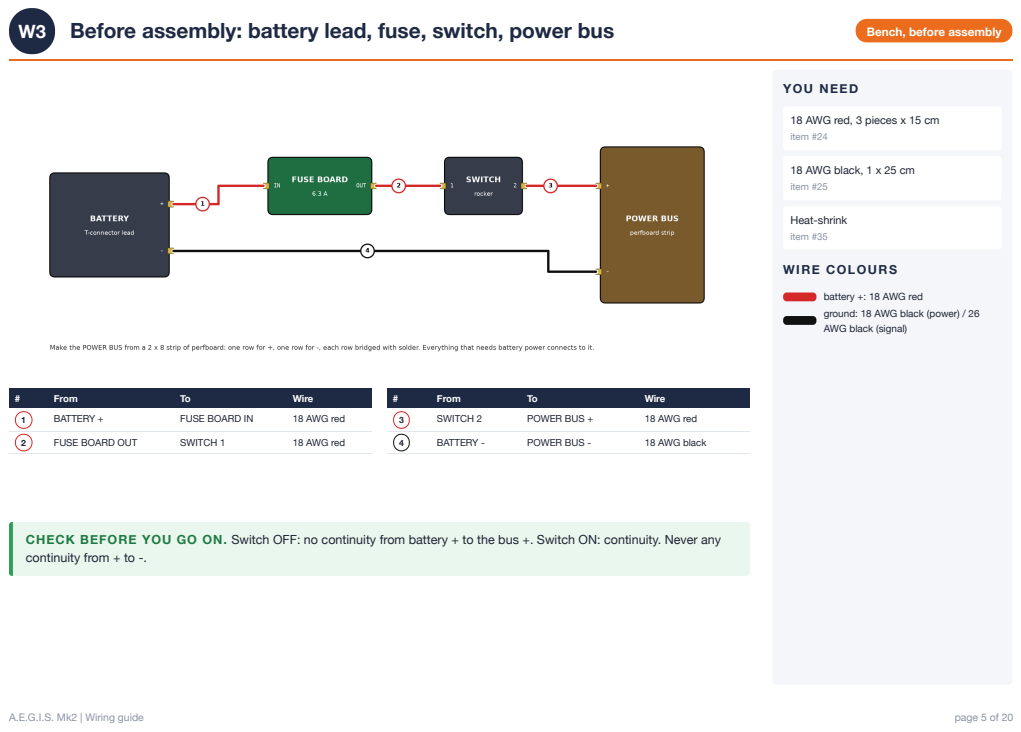
[picture p94: page 5]
From; Wire; BATTERY +; FUSE BOARD IN; 18 AWG red; FUSE BOARD OUT; SWITCH 1; SWITCH 2; POWER BUS +; BATTERY -; POWER BUS -; 18 AWG black; Heat-shrink; item #35; WIRE COLOURS

18 AWG red, 3 pieces x 15 cm
item #24

18 AWG black, 1 x 25 cm
item #25

battery +: 18 AWG red
ground: 18 AWG black (power) / 26
AWG black (signal)

CHECK BEFORE YOU GO ON. Switch OFF: no continuity from battery + to the bus +. Switch ON: continuity. Never any
continuity from + to -.

W4 Step 16 a: power to regulators and motor drivers | Assembly step 16: lower deck

## YOU NEED

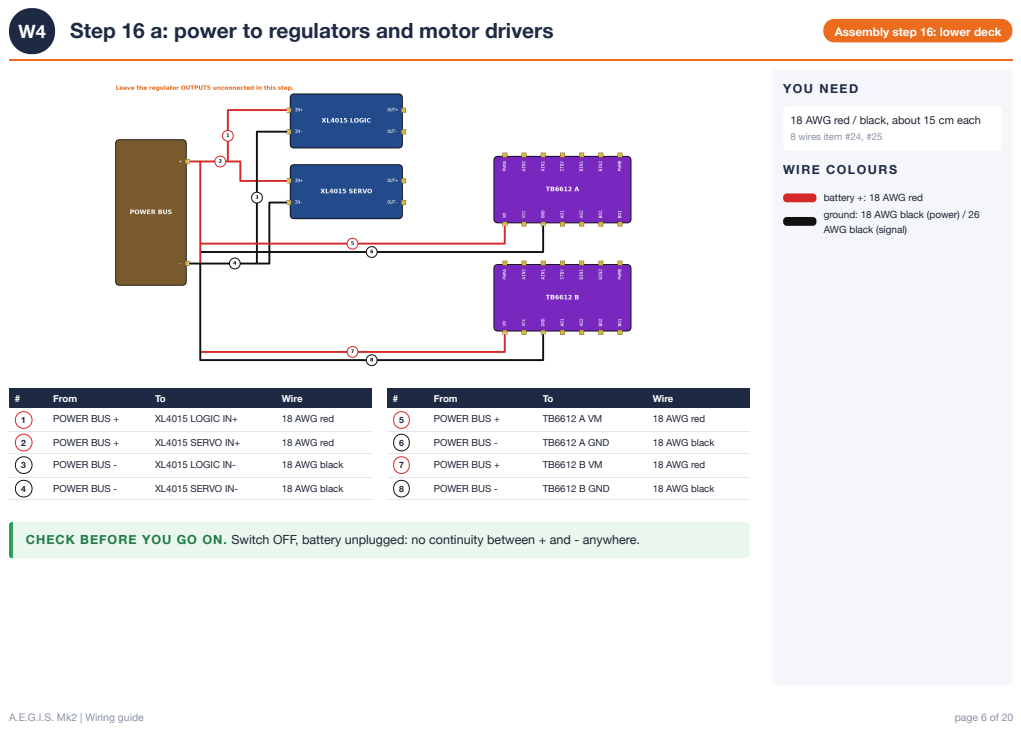
[picture p95: page 6]
From; Wire; POWER BUS +; XL4015 LOGIC IN+; 18 AWG red; XL4015 SERVO IN+; POWER BUS -; XL4015 LOGIC IN-; 18 AWG black; XL4015 SERVO IN-; TB6612 A GND; TB6612 B GND; WIRE COLOURS

18 AWG red / black, about 15 cm each
8 wires item #24, #25

battery +: 18 AWG red
ground: 18 AWG black (power) / 26
AWG black (signal)

CHECK BEFORE YOU GO ON. Switch OFF, battery unplugged: no continuity between + and - anywhere.

W5 Step 16 b: set both regulators to 5.0 V | Assembly step 16: lower deck

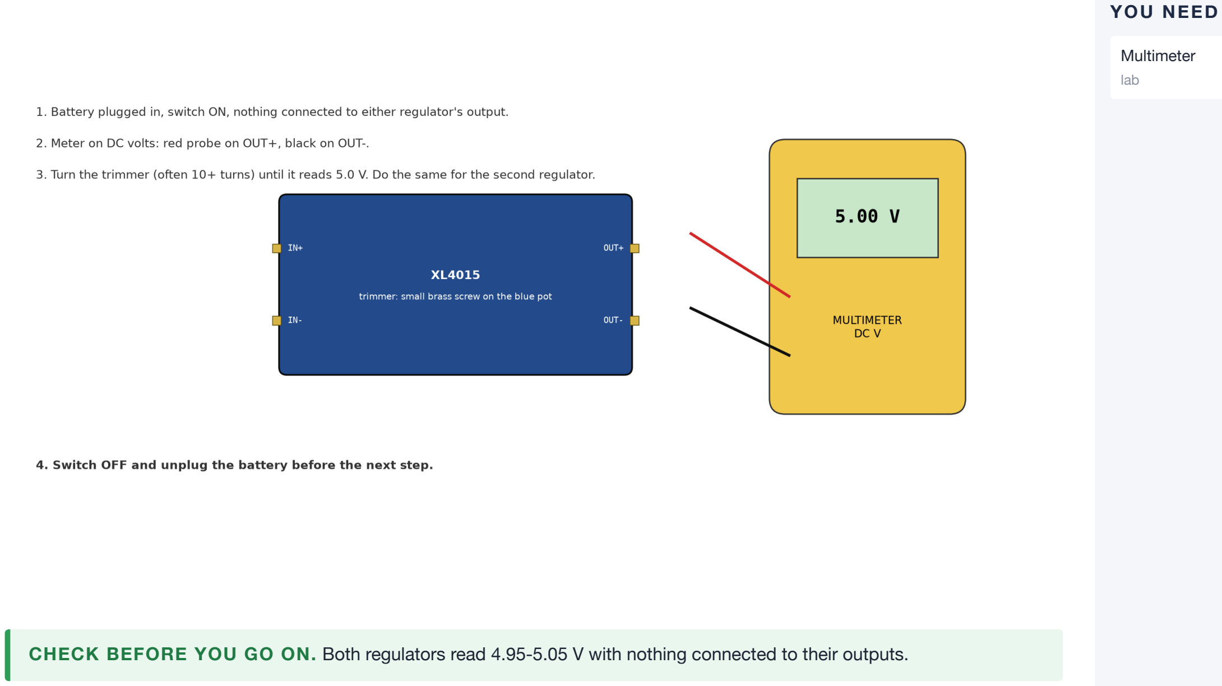
[picture p96: figure]
YOU NEED; Multimeter; lab

CHECK BEFORE YOU GO ON. Both regulators read 4.95-5.05 V with nothing connected to their outputs.

W6 Step 16 c: motors to the motor drivers | Assembly step 16: lower deck

## YOU NEED

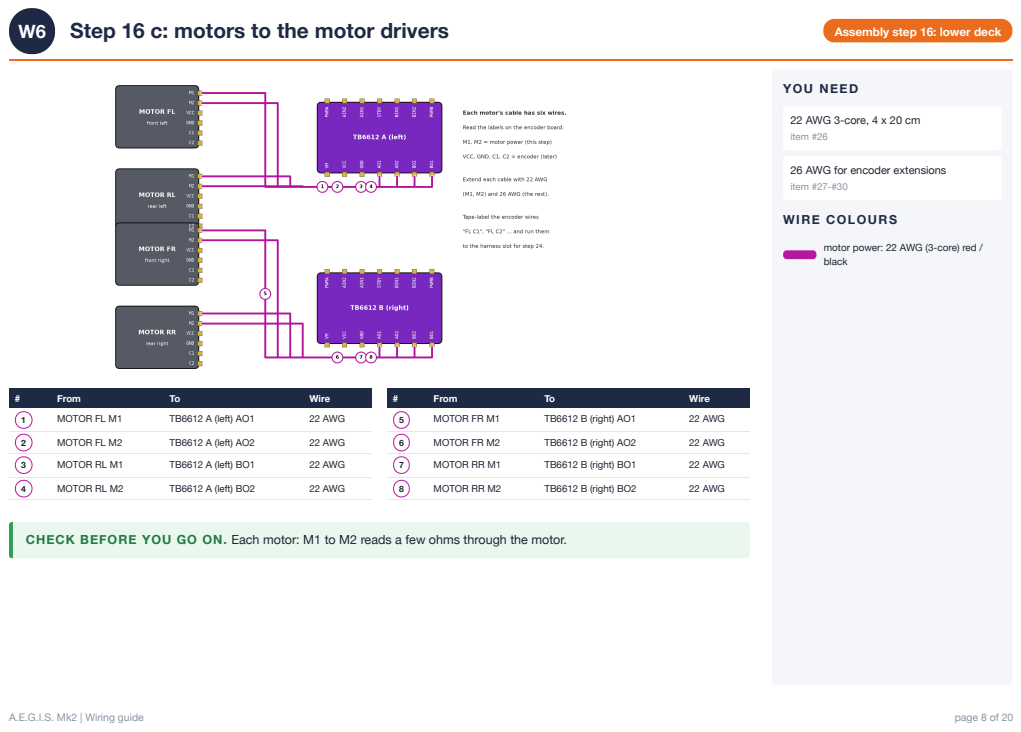
[picture p97: page 8]
From; Wire; MOTOR FL M1; TB6612 A (left) AO1; 22 AWG; MOTOR FL M2; TB6612 A (left) AO2; MOTOR RL M1; TB6612 A (left) BO1; MOTOR RL M2; TB6612 A (left) BO2; MOTOR FR M1; TB6612 B (right) AO1; MOTOR FR M2; TB6612 B (right) AO2; MOTOR RR M1; TB6612 B (right) BO1; MOTOR RR M2; TB6612 B (right) BO2; WIRE COLOURS

22 AWG 3-core, 4 x 20 cm
item #26

26 AWG for encoder extensions
item #27-#30

motor power: 22 AWG (3-core) red /
black

CHECK BEFORE YOU GO ON. Each motor: M1 to M2 reads a few ohms through the motor.

## YOU NEED

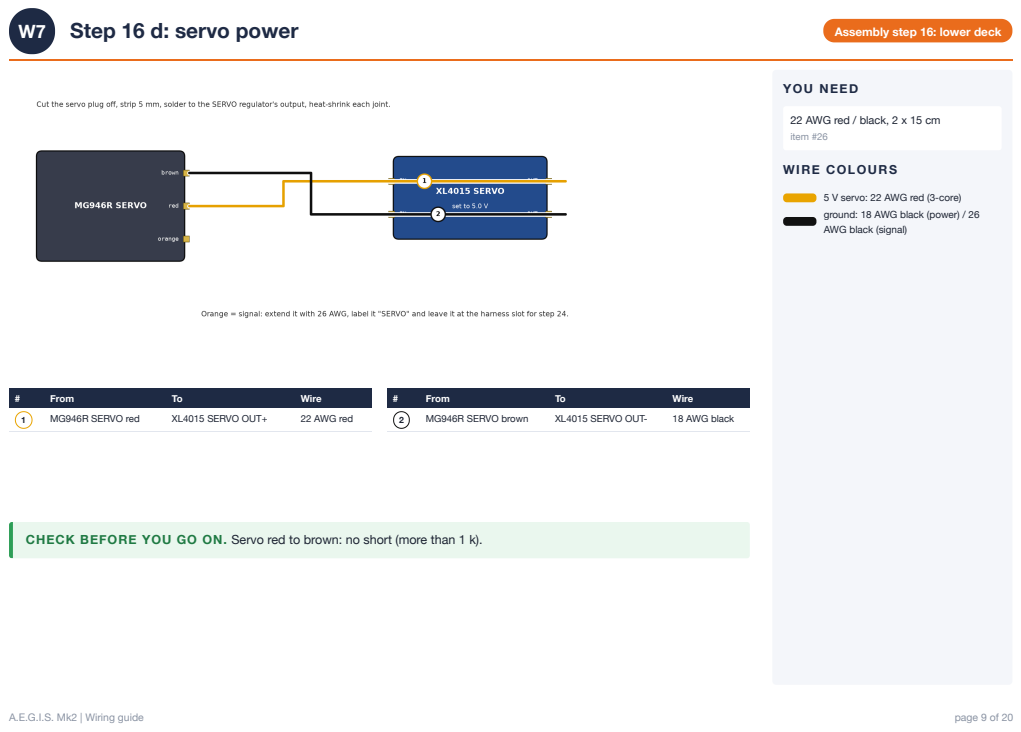
[picture p98: page 9]
W7 Step 16 d: servo power; Assembly step 16: lower deck; From; Wire; MG946R SERVO red; XL4015 SERVO OUT+; 22 AWG red; MG946R SERVO brown; XL4015 SERVO OUT-; 18 AWG black; WIRE COLOURS

22 AWG red / black, 2 x 15 cm
item #26

5 V servo: 22 AWG red (3-core)
ground: 18 AWG black (power) / 26
AWG black (signal)

CHECK BEFORE YOU GO ON. Servo red to brown: no short (more than 1 k).

W8 Step 16 e: edge sensors and bay sensor to the PCF8574 | Assembly step 16: lower deck

## YOU NEED

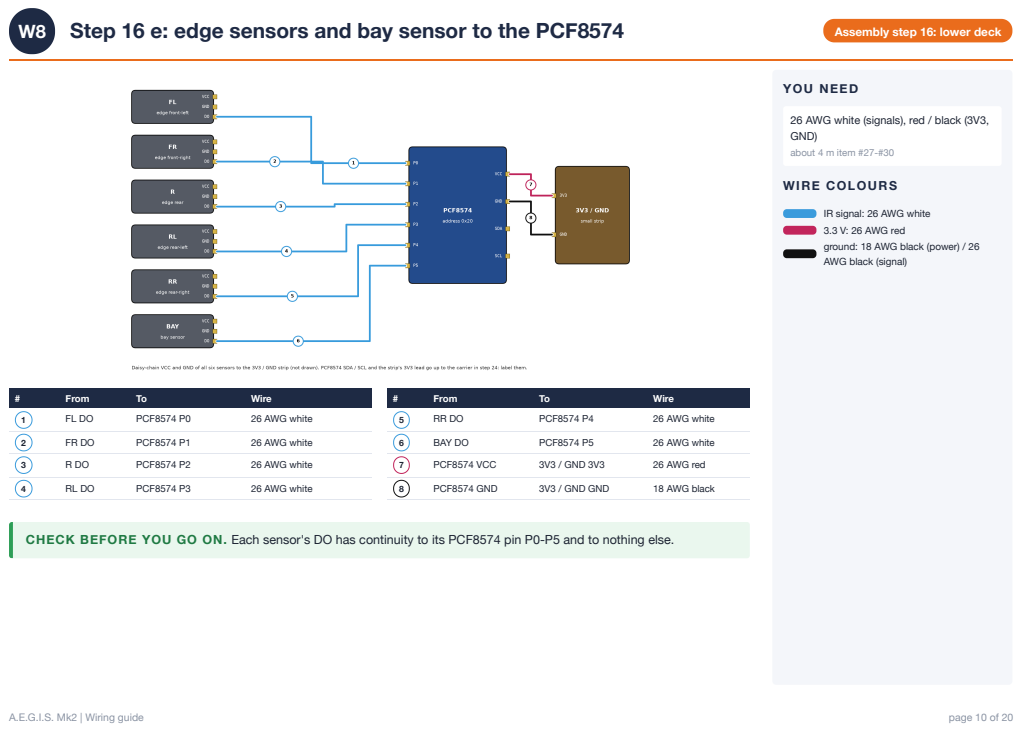
[picture p99: page 10]
From; Wire; PCF8574 P0; 26 AWG white; PCF8574 P1; PCF8574 P2; PCF8574 P3; PCF8574 P4; BAY DO; PCF8574 P5; PCF8574 VCC; 3V3 / GND 3V3; 26 AWG red; PCF8574 GND; 3V3 / GND GND; 18 AWG black; WIRE COLOURS

26 AWG white (signals), red / black (3V3,
GND)
about 4 m item #27-#30

IR signal: 26 AWG white
3.3 V: 26 AWG red
ground: 18 AWG black (power) / 26
AWG black (signal)

CHECK BEFORE YOU GO ON. Each sensor's DO has continuity to its PCF8574 pin P0-P5 and to nothing else.

W9 Step 16 f: label and route the leads for the upper deck | Assembly step 16: lower deck

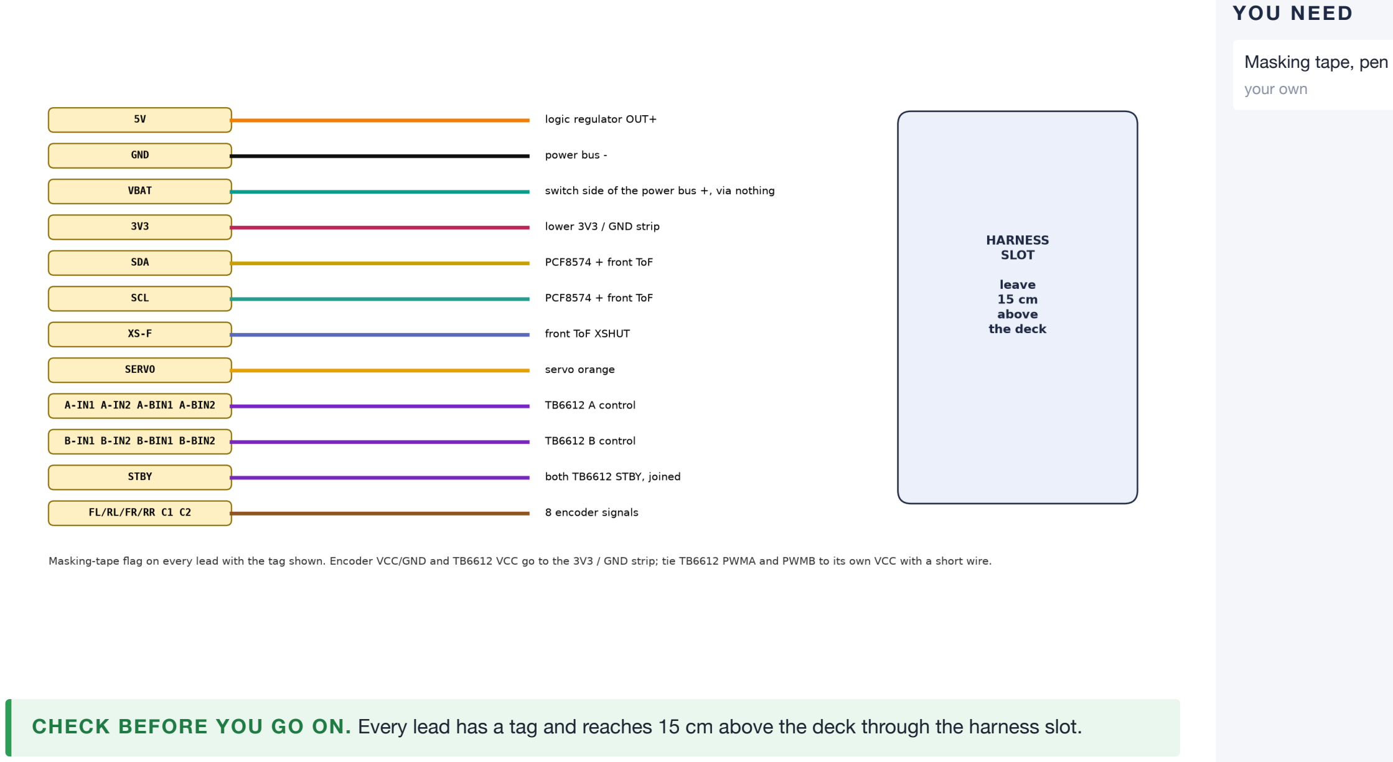
[picture p100: figure]
YOU NEED; Masking tape, pen; your own

CHECK BEFORE YOU GO ON. Every lead has a tag and reaches 15 cm above the deck through the harness slot.

W10 Step 24 a: power to the carrier and the camera | Assembly step 24: upper deck

## YOU NEED

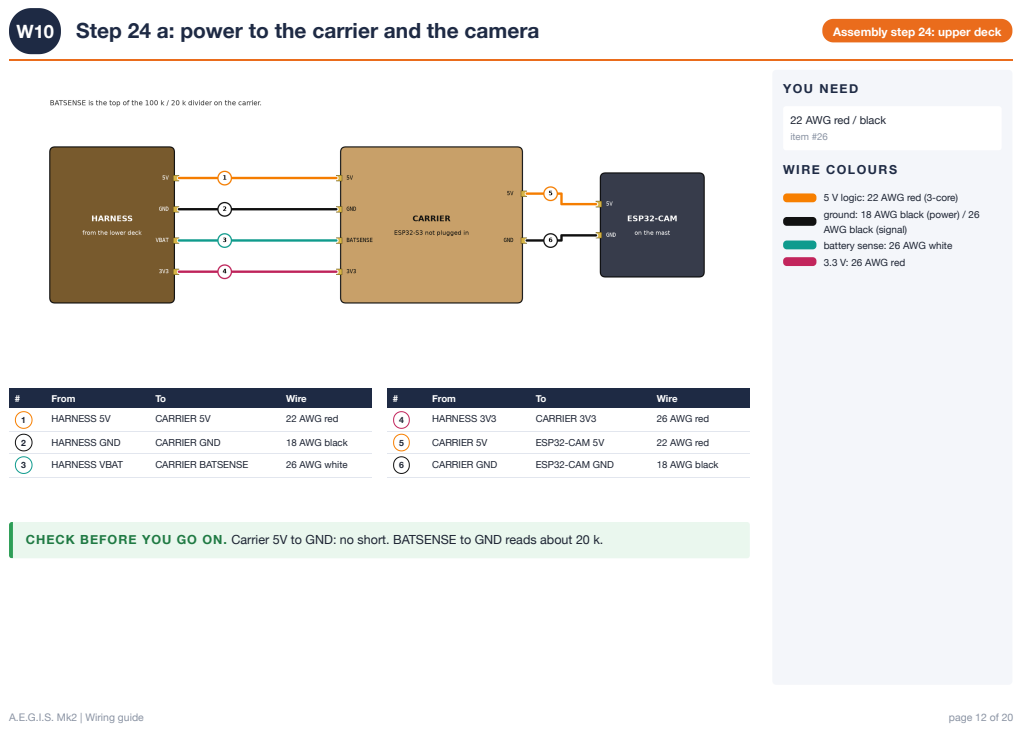
[picture p101: page 12]
From; Wire; HARNESS 5V; CARRIER 5V; 22 AWG red; HARNESS GND; CARRIER GND; 18 AWG black; HARNESS VBAT; CARRIER BATSENSE; 26 AWG white; HARNESS 3V3; CARRIER 3V3; 26 AWG red; ESP32-CAM 5V; ESP32-CAM GND; WIRE COLOURS

22 AWG red / black
item #26

5 V logic: 22 AWG red (3-core)
ground: 18 AWG black (power) / 26
AWG black (signal)
battery sense: 26 AWG white
3.3 V: 26 AWG red

CHECK BEFORE YOU GO ON. Carrier 5V to GND: no short. BATSENSE to GND reads about 20 k.

W11 Step 24 b: I2C sensors (gyro, distance sensors, PCF8574) | Assembly step 24: upper deck

## YOU NEED

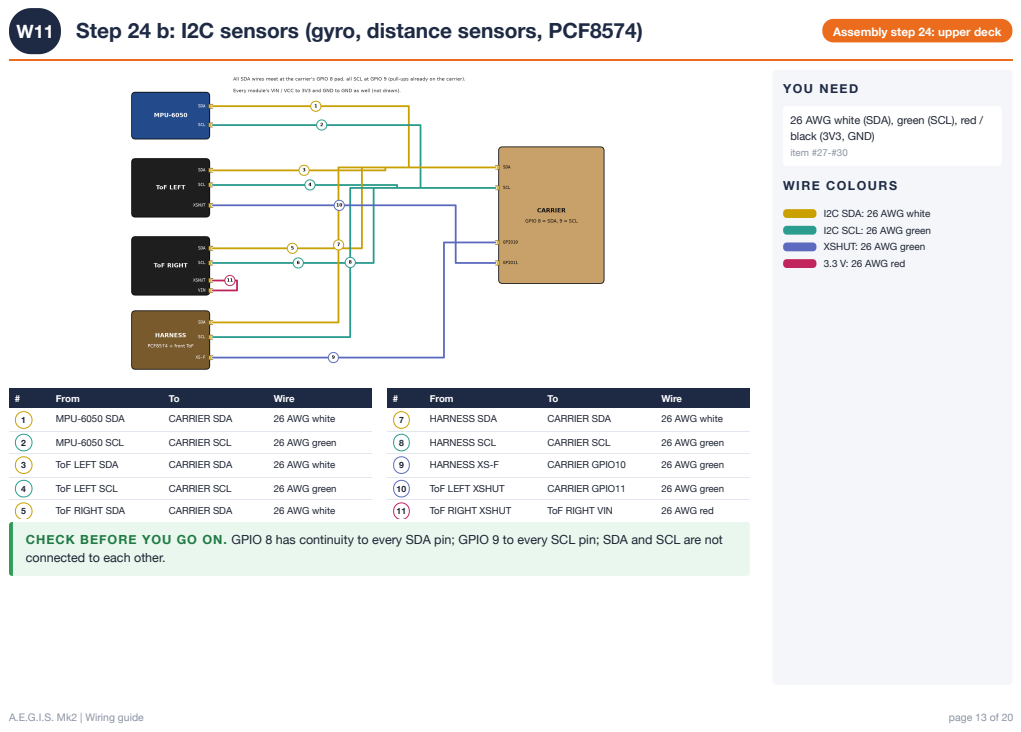
[picture p102: page 13]
From; Wire; MPU-6050 SDA; CARRIER SDA; 26 AWG white; MPU-6050 SCL; CARRIER SCL; 26 AWG green; ToF LEFT SDA; ToF LEFT SCL; ToF RIGHT SDA; HARNESS SDA; HARNESS SCL; HARNESS XS-F; CARRIER GPIO10; ToF LEFT XSHUT; CARRIER GPIO11; ToF RIGHT XSHUT; ToF RIGHT VIN; 26 AWG red; WIRE COLOURS

26 AWG white (SDA), green (SCL), red /
black (3V3, GND)
item #27-#30

I2C SDA: 26 AWG white
I2C SCL: 26 AWG green
XSHUT: 26 AWG green
3.3 V: 26 AWG red

CHECK BEFORE YOU GO ON. GPIO 8 has continuity to every SDA pin; GPIO 9 to every SCL pin; SDA and SCL are not
connected to each other.

## YOU NEED

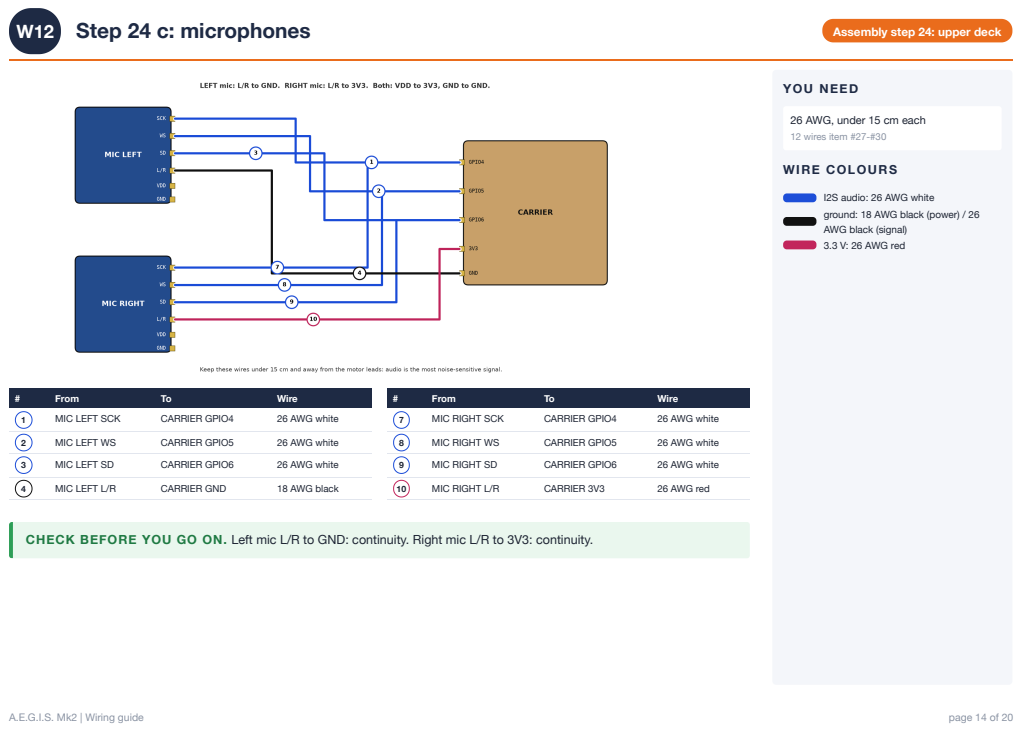
[picture p103: page 14]
W12 Step 24 c: microphones; Assembly step 24: upper deck; From; Wire; MIC LEFT SCK; CARRIER GPIO4; 26 AWG white; MIC LEFT WS; CARRIER GPIO5; MIC LEFT SD; CARRIER GPIO6; MIC LEFT L/R; CARRIER GND; 18 AWG black; MIC RIGHT SCK; MIC RIGHT WS; MIC RIGHT SD; MIC RIGHT L/R; CARRIER 3V3; 26 AWG red; WIRE COLOURS

26 AWG, under 15 cm each
12 wires item #27-#30

I2S audio: 26 AWG white
ground: 18 AWG black (power) / 26
AWG black (signal)
3.3 V: 26 AWG red

CHECK BEFORE YOU GO ON. Left mic L/R to GND: continuity. Right mic L/R to 3V3: continuity.

W13 Step 24 d: motor-driver control | Assembly step 24: upper deck

## YOU NEED

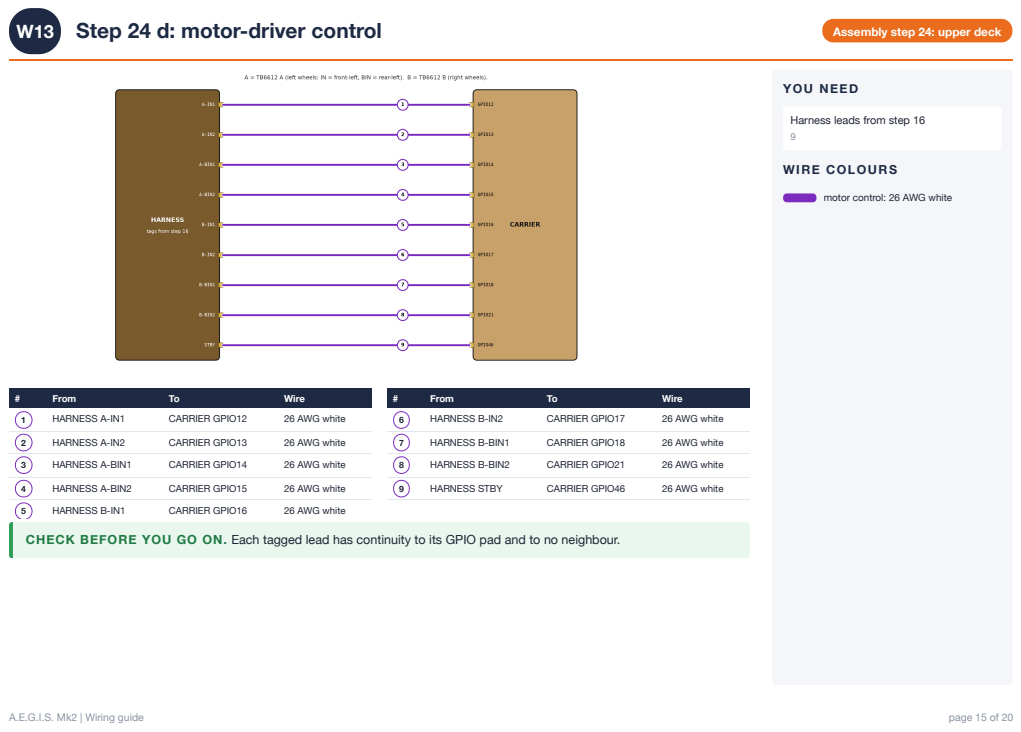
[picture p104: page 15]
From; Wire; HARNESS A-IN1; CARRIER GPIO12; 26 AWG white; HARNESS A-IN2; CARRIER GPIO13; HARNESS A-BIN1; CARRIER GPIO14; HARNESS A-BIN2; CARRIER GPIO15; HARNESS B-IN1; CARRIER GPIO16; HARNESS B-IN2; CARRIER GPIO17; HARNESS B-BIN1; CARRIER GPIO18; HARNESS B-BIN2; CARRIER GPIO21; HARNESS STBY; CARRIER GPIO46; WIRE COLOURS

Harness leads from step 16

motor control: 26 AWG white

CHECK BEFORE YOU GO ON. Each tagged lead has continuity to its GPIO pad and to no neighbour.

W14 Step 24 e: encoders and servo signal | Assembly step 24: upper deck

## YOU NEED

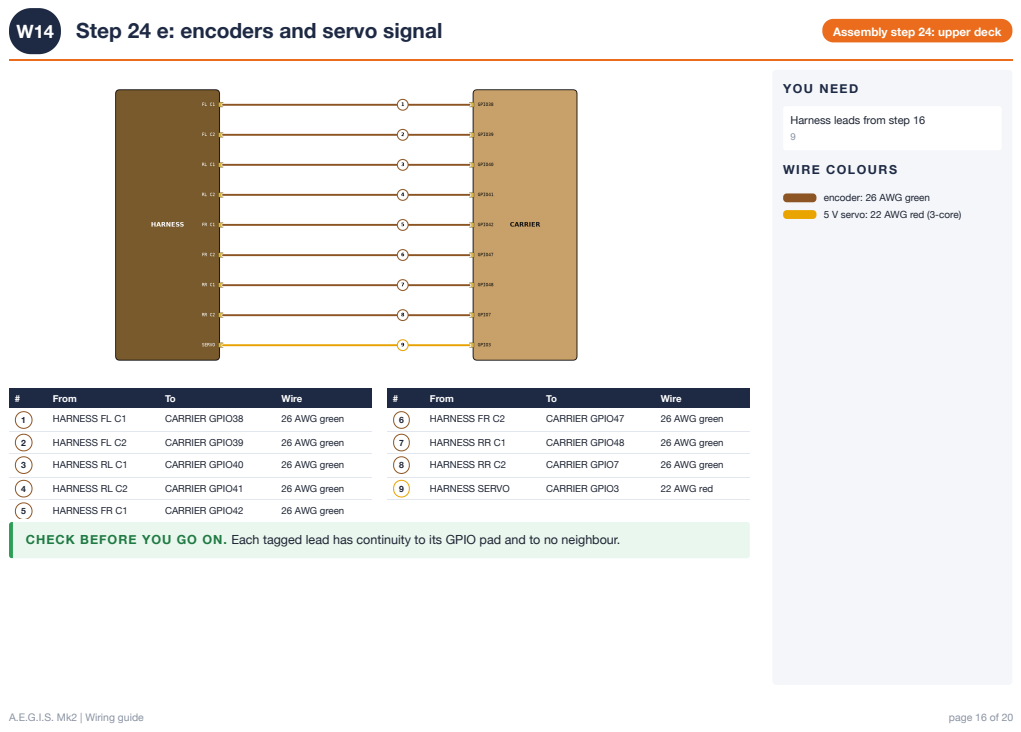
[picture p105: page 16]
From; Wire; HARNESS FL C1; CARRIER GPIO38; 26 AWG green; HARNESS FL C2; CARRIER GPIO39; HARNESS RL C1; CARRIER GPIO40; HARNESS RL C2; CARRIER GPIO41; HARNESS FR C1; CARRIER GPIO42; HARNESS FR C2; CARRIER GPIO47; HARNESS RR C1; CARRIER GPIO48; HARNESS RR C2; CARRIER GPIO7; HARNESS SERVO; CARRIER GPIO3; 22 AWG red; WIRE COLOURS

Harness leads from step 16

encoder: 26 AWG green
5 V servo: 22 AWG red (3-core)

CHECK BEFORE YOU GO ON. Each tagged lead has continuity to its GPIO pad and to no neighbour.

W15 First power-up | Assembly step 24: upper deck

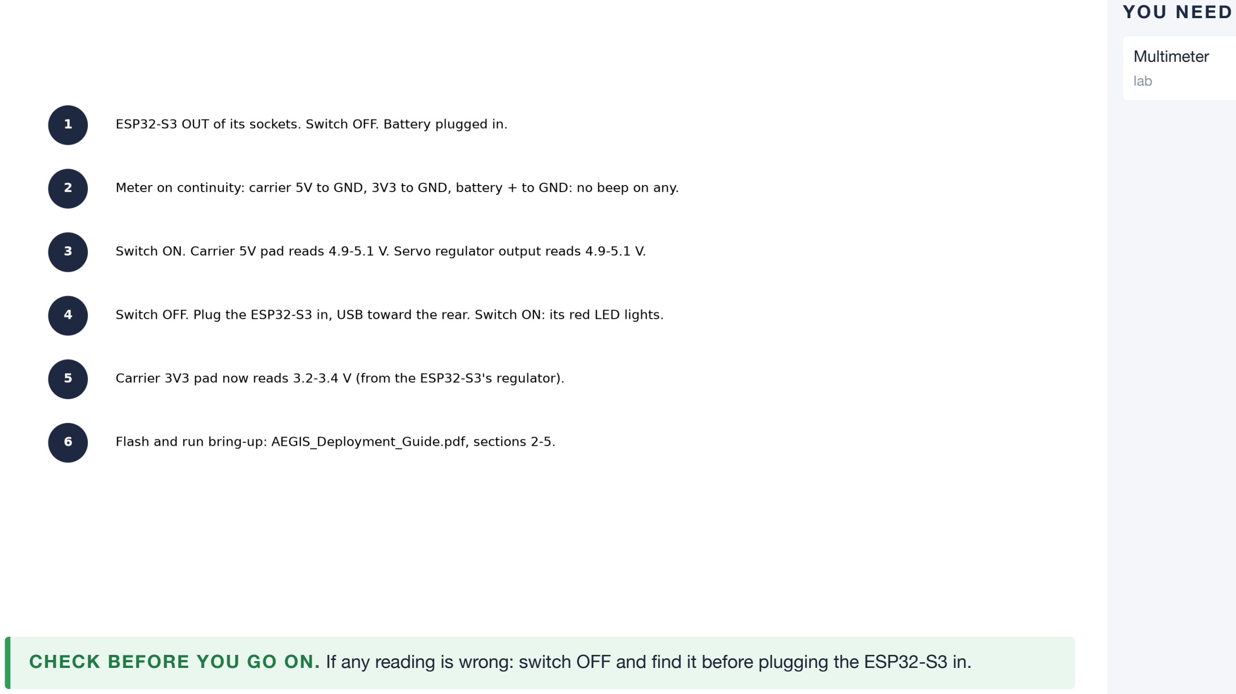
[picture p106: figure]
YOU NEED; Multimeter; lab

CHECK BEFORE YOU GO ON. If any reading is wrong: switch OFF and find it before plugging the ESP32-S3 in.

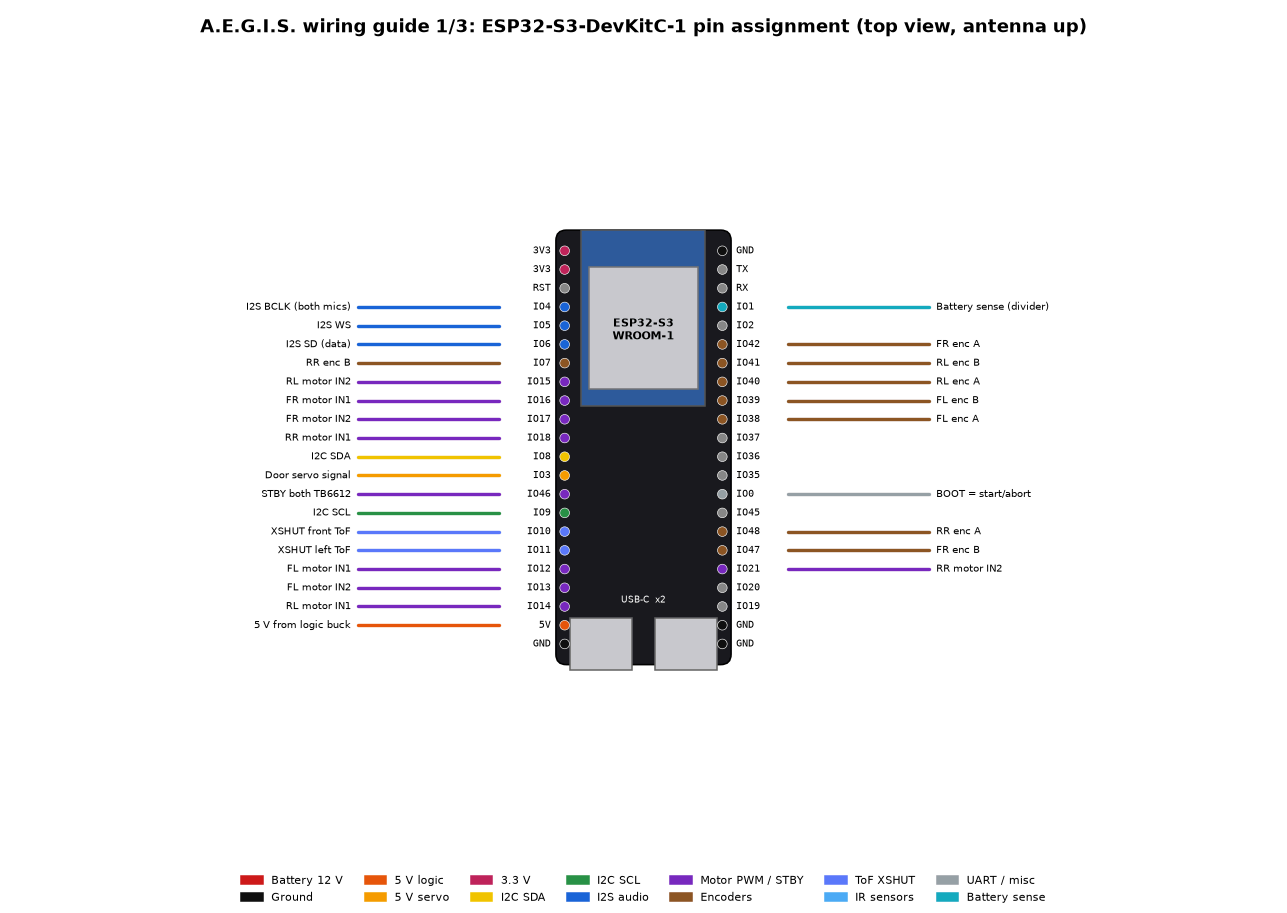
[picture p107: page 18]

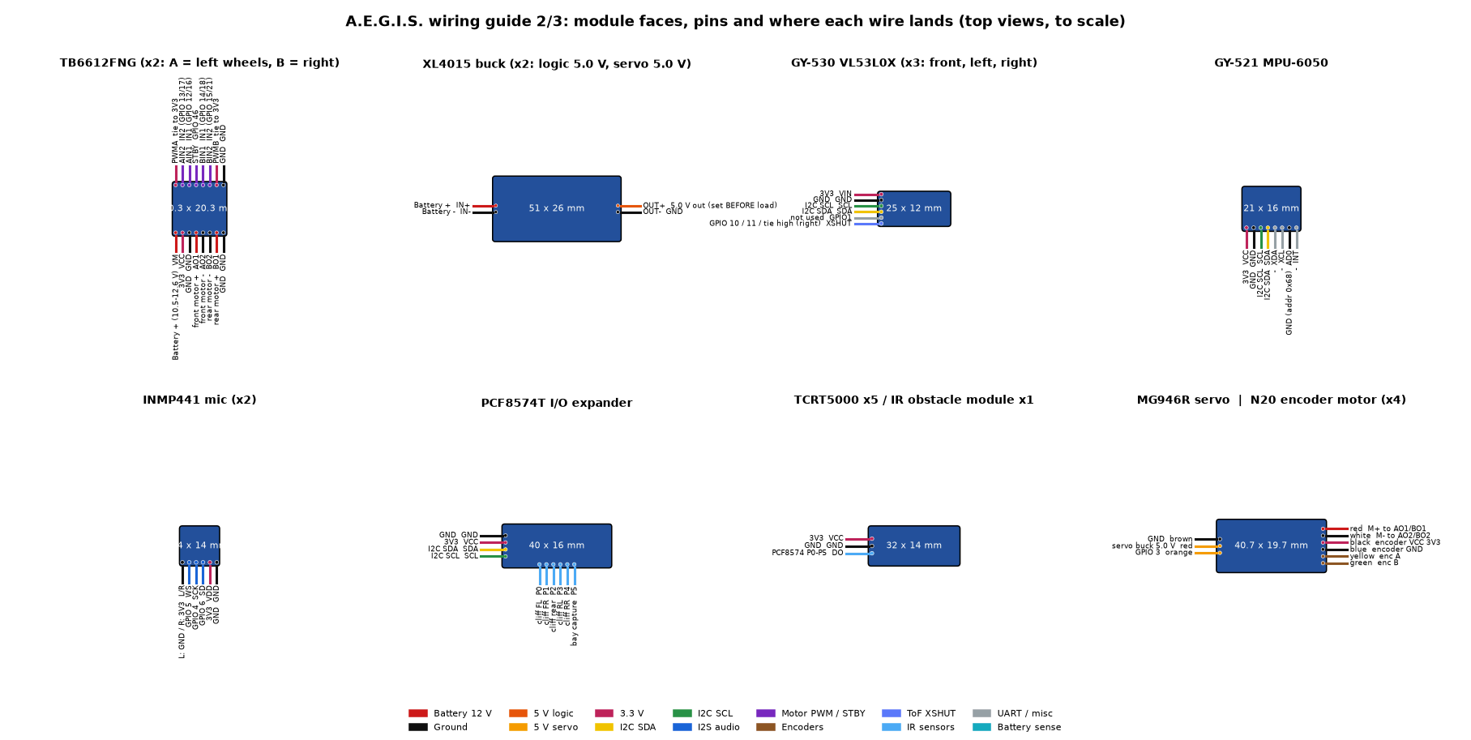
[picture p108: figure]
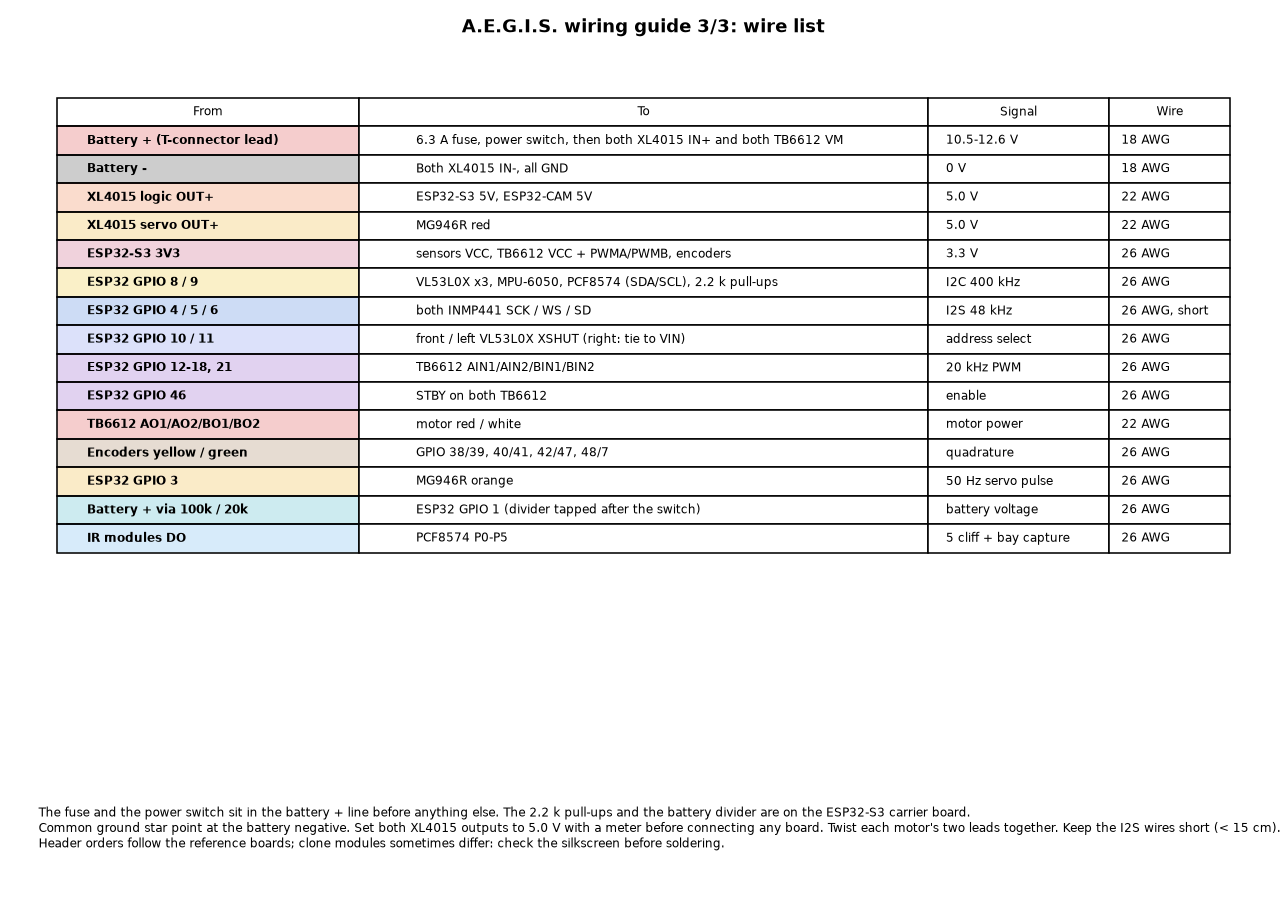
[picture p109: page 20]
