yatharth1011/aegis-rescue-rover/team_share/AEGIS_Wiring_Guide_p3.png

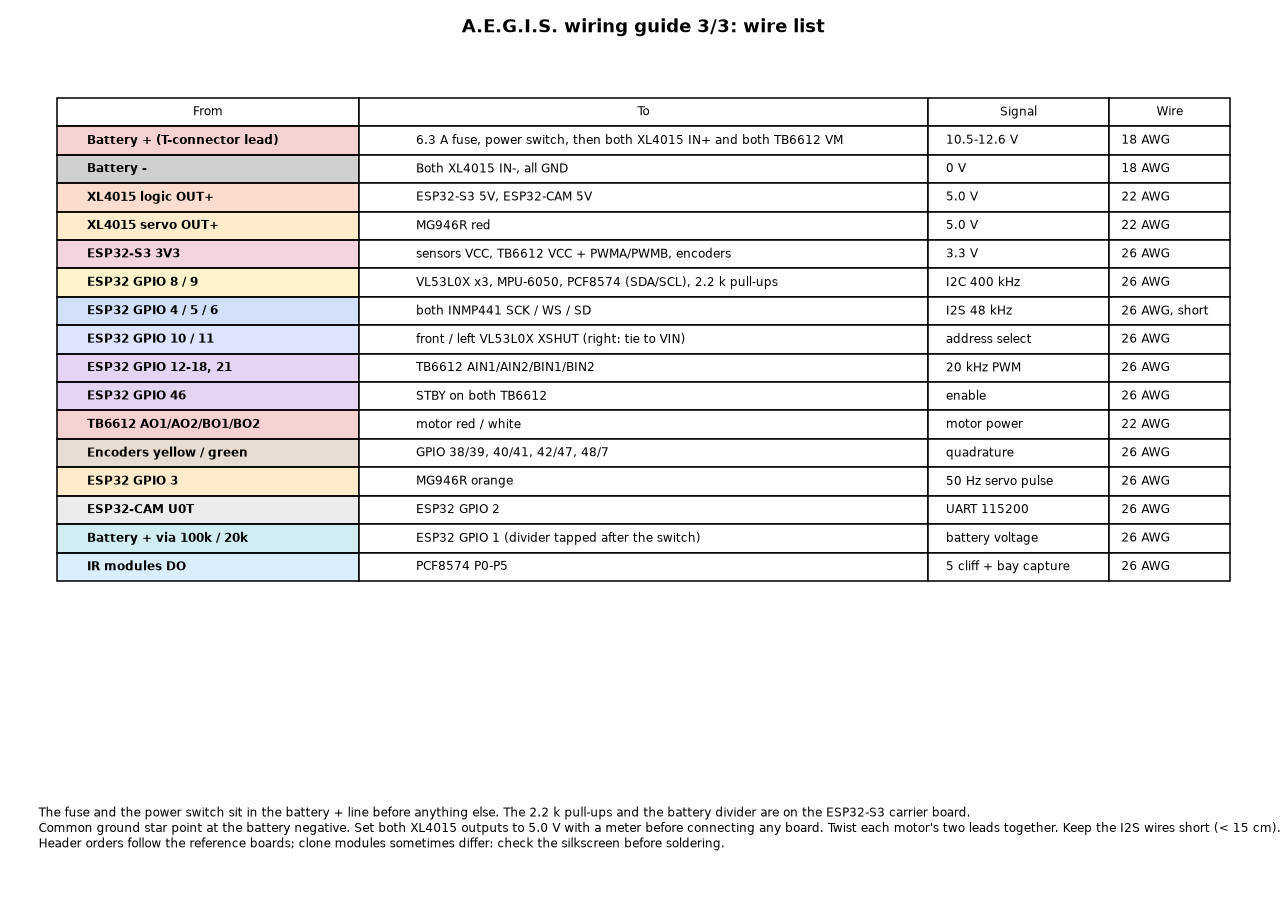
team_share/AEGIS_Wiring_Guide_p3.png
