yatharth1011/aegis-rescue-rover/team_share/Build_AEGIS_Rover/output_detailed/render_front.png

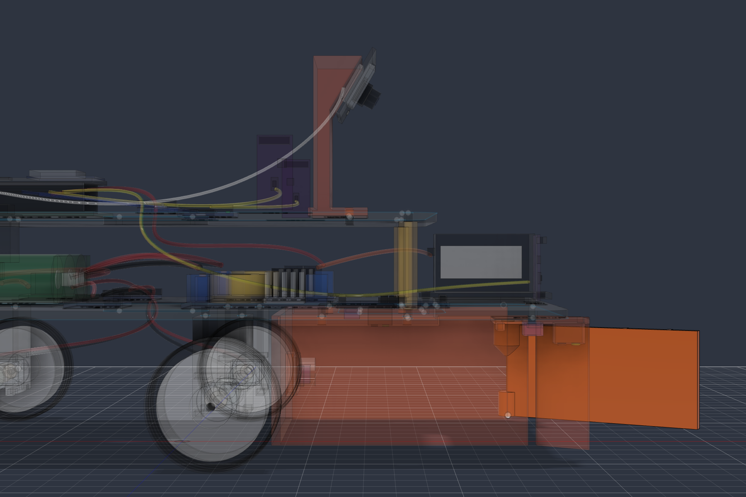
team_share/Build_AEGIS_Rover/output_detailed/render_front.png
