yatharth1011/aegis-rescue-rover/team_share/Build_AEGIS_Rover/output_detailed/render_iso_rear.png

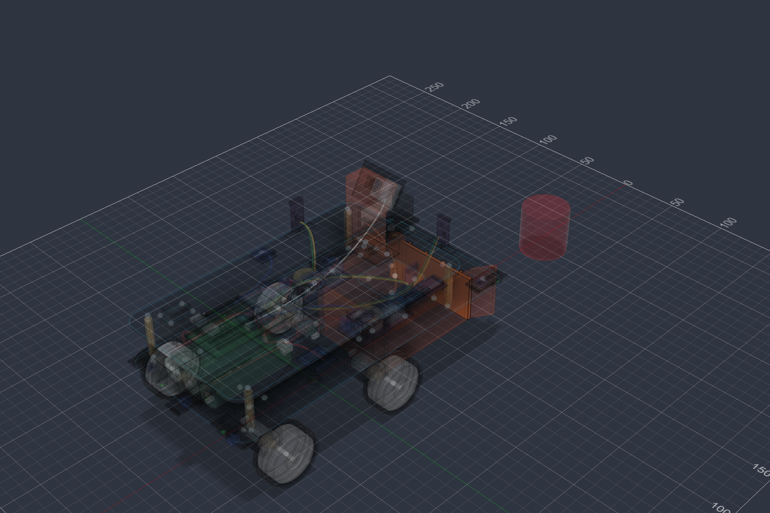
team_share/Build_AEGIS_Rover/output_detailed/render_iso_rear.png
