yatharth1011/aegis-rescue-rover/team_share/Build_AEGIS_Rover/output_detailed/render_wiring_top.png

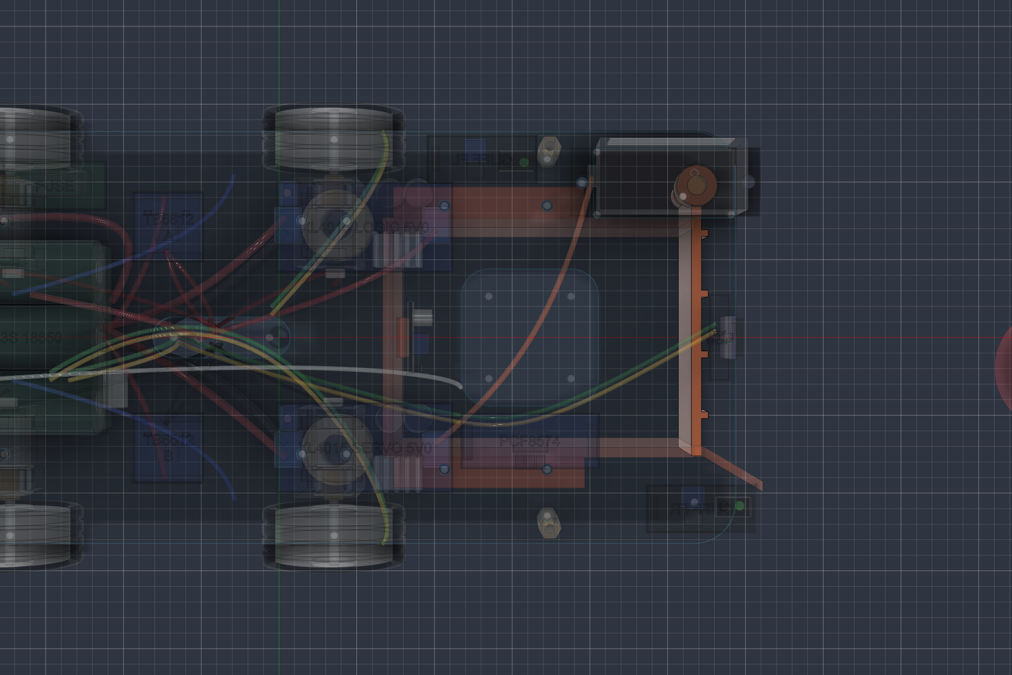
team_share/Build_AEGIS_Rover/output_detailed/render_wiring_top.png
