yatharth1011/aegis-rescue-rover/team_share/deck_assets/guides/assembly/step20.png

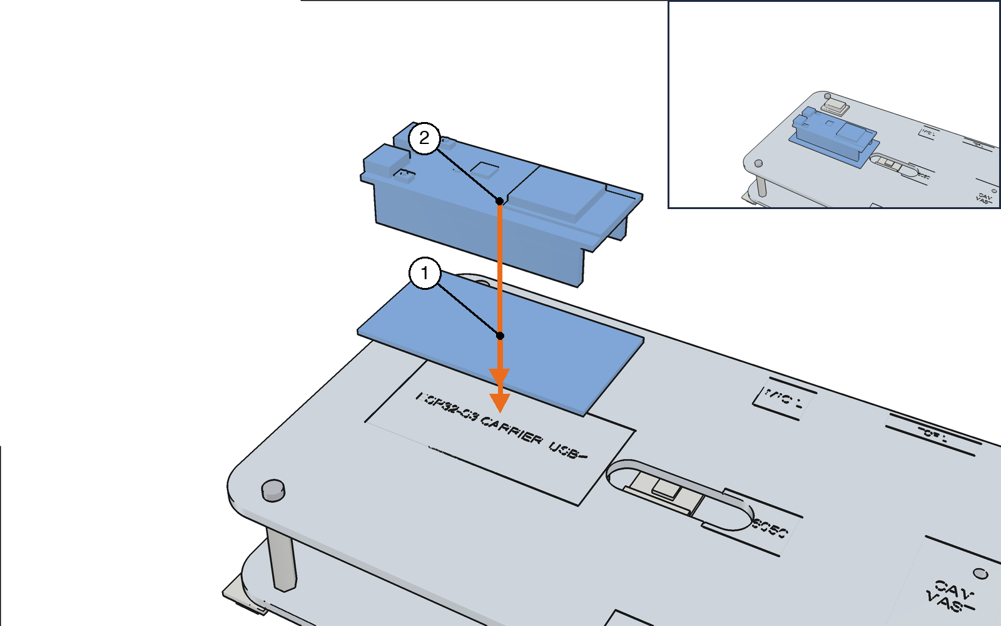
team_share/deck_assets/guides/assembly/step20.png
