yatharth1011/aegis-rescue-rover/team_share/deck_assets/guides/assembly/step23.png

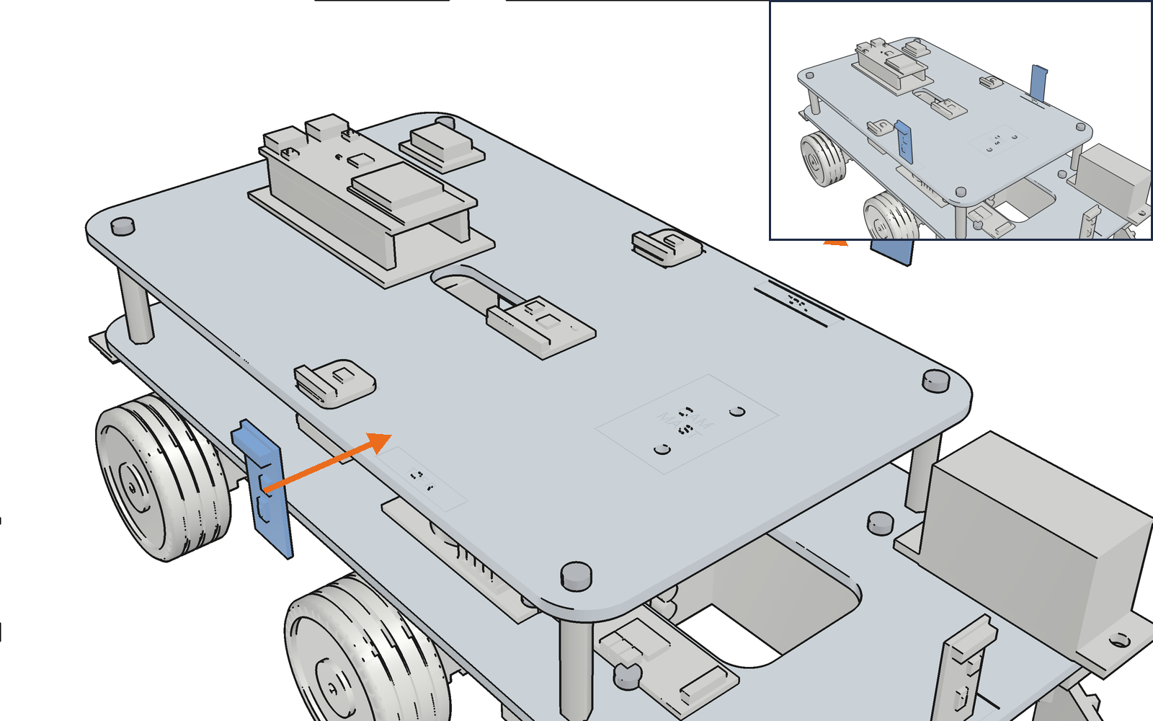
team_share/deck_assets/guides/assembly/step23.png
