yatharth1011/aegis-rescue-rover/team_share/deck_assets/guides/decks.png

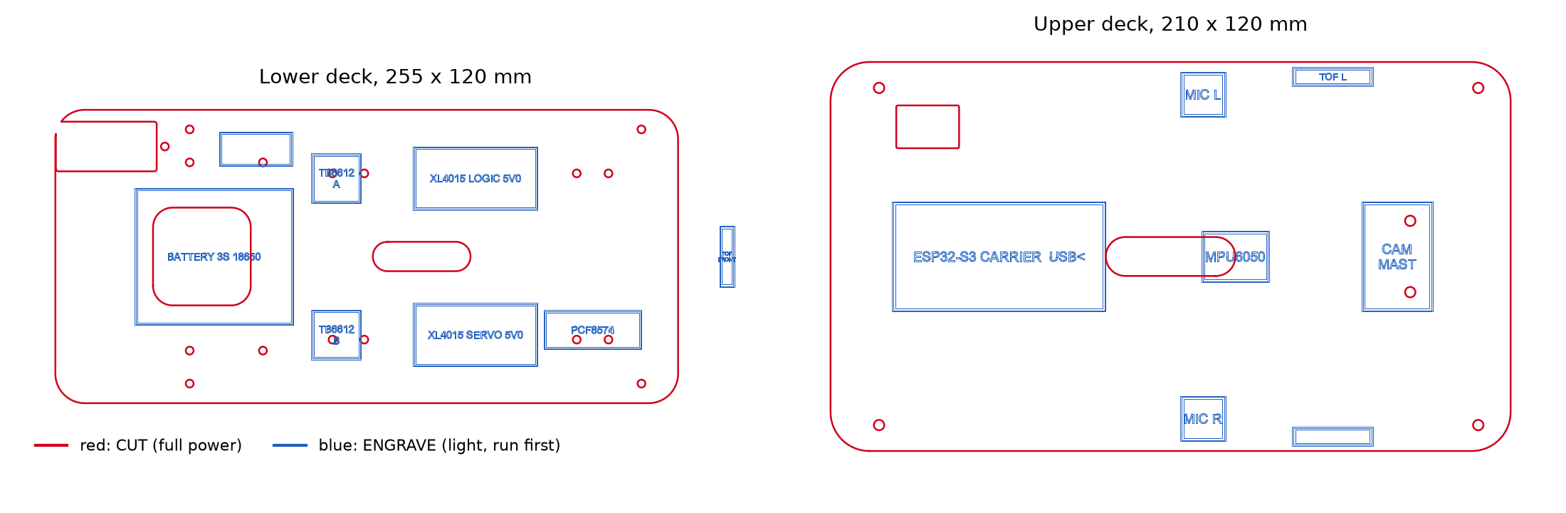
team_share/deck_assets/guides/decks.png
