yatharth1011/aegis-rescue-rover/team_share/deck_assets/guides/plates.png

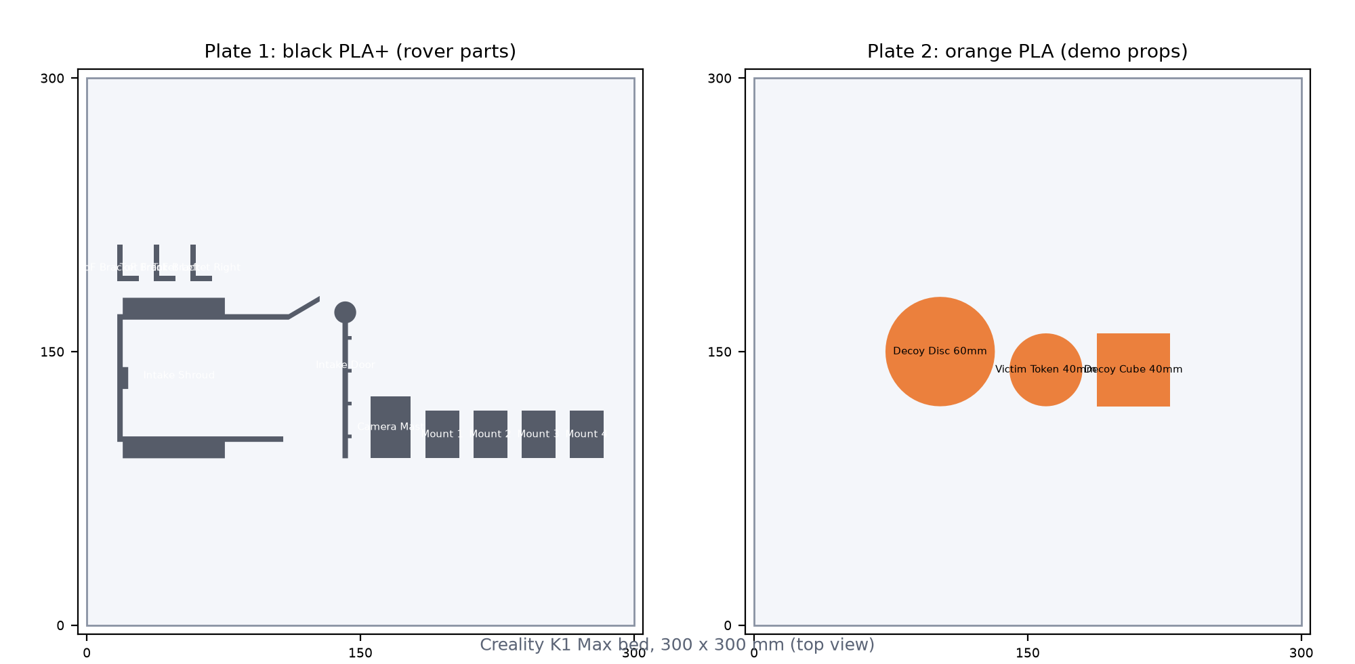
team_share/deck_assets/guides/plates.png
