yatharth1011/aegis-rescue-rover/team_share/deck_assets/guides/safety.png

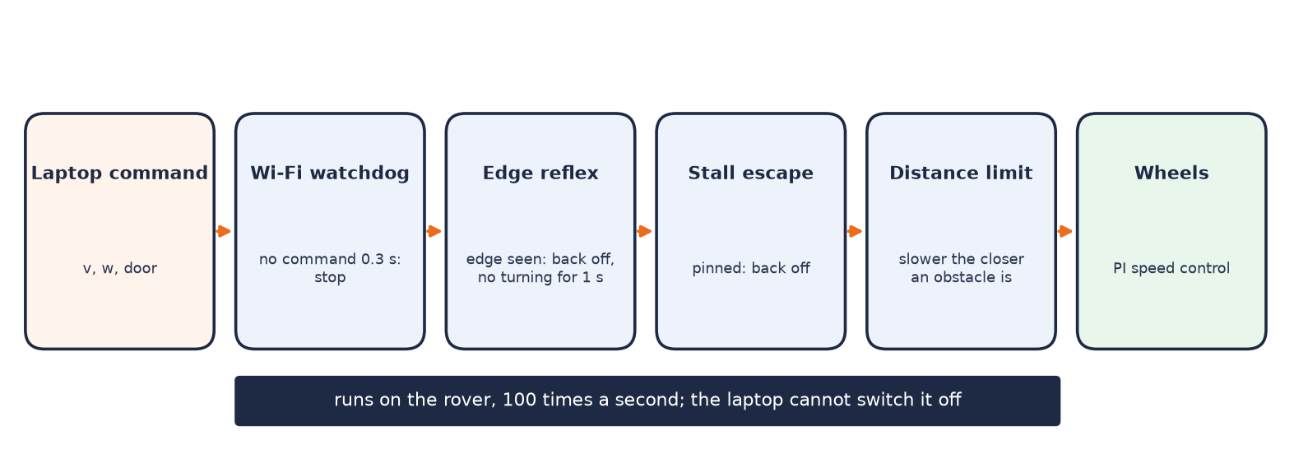
team_share/deck_assets/guides/safety.png
