yatharth1011/aegis-rescue-rover/team_share/deck_assets/guides/system.png

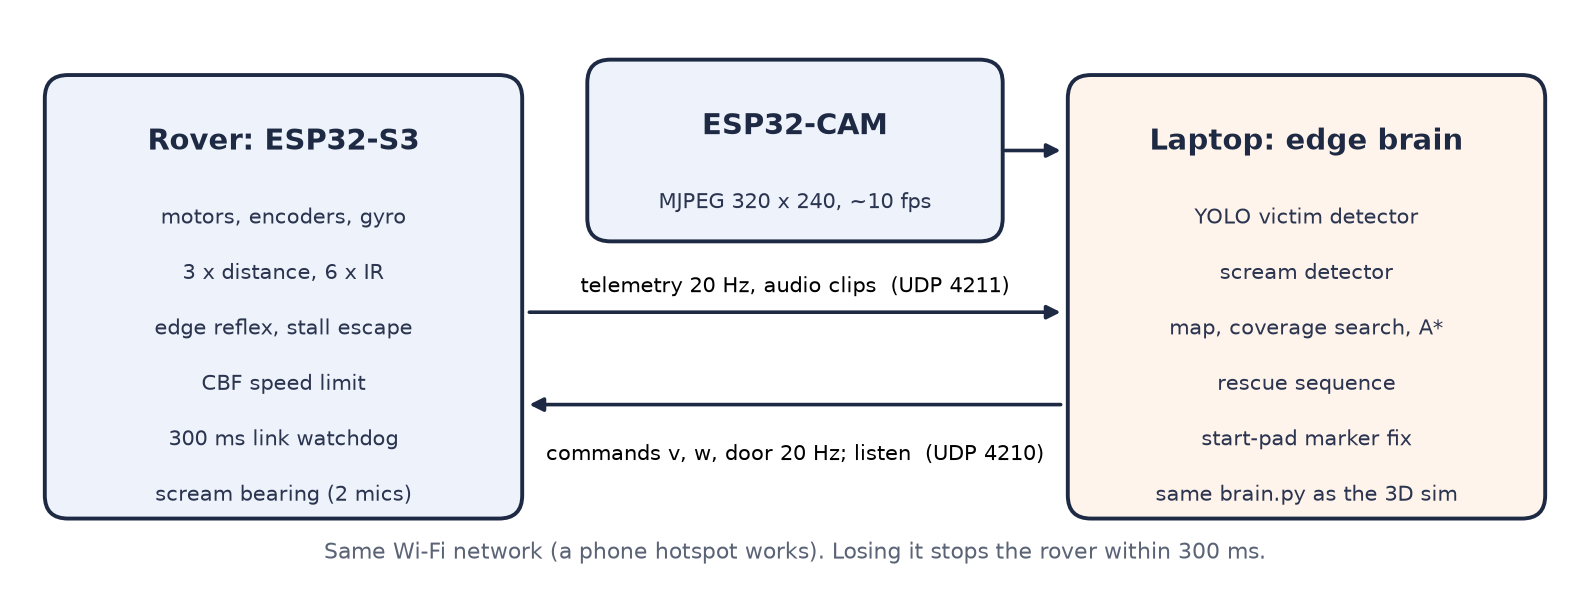
team_share/deck_assets/guides/system.png
