yatharth1011/aegis-rescue-rover/team_share/deck_assets/render_wiring_lower_deck.png

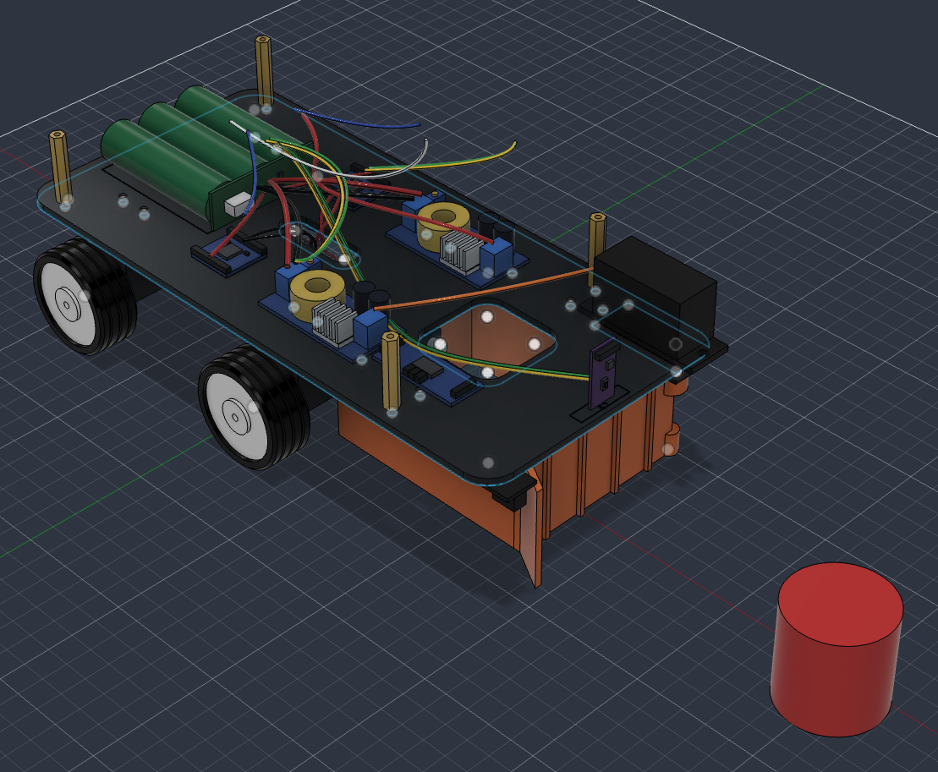
team_share/deck_assets/render_wiring_lower_deck.png
