yatharth1011/aegis-rescue-rover/team_share/deck_assets/render_wiring_top.png

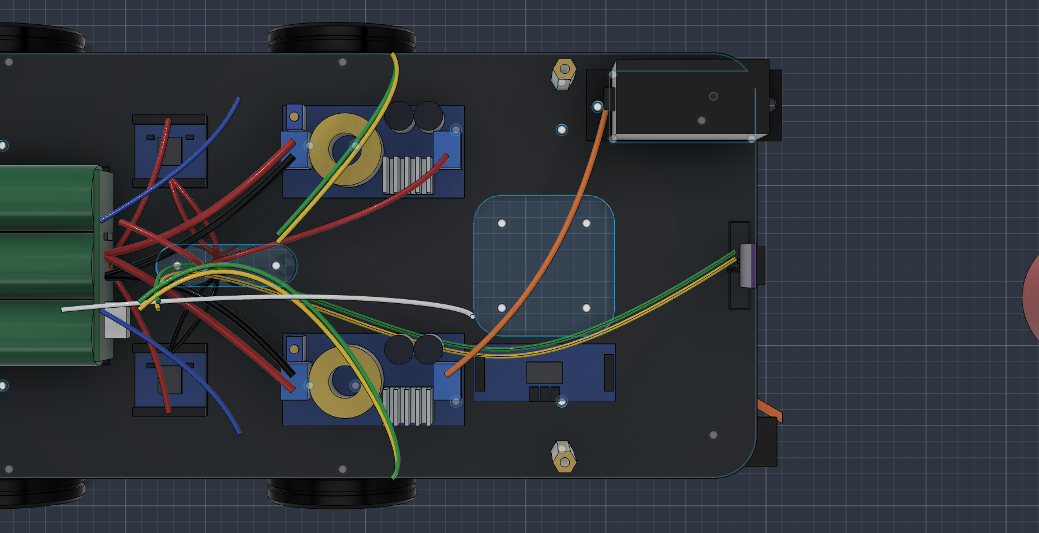
team_share/deck_assets/render_wiring_top.png
