yatharth1011/aegis-rescue-rover/team_share/deck_assets/wiring_guide_crop.png

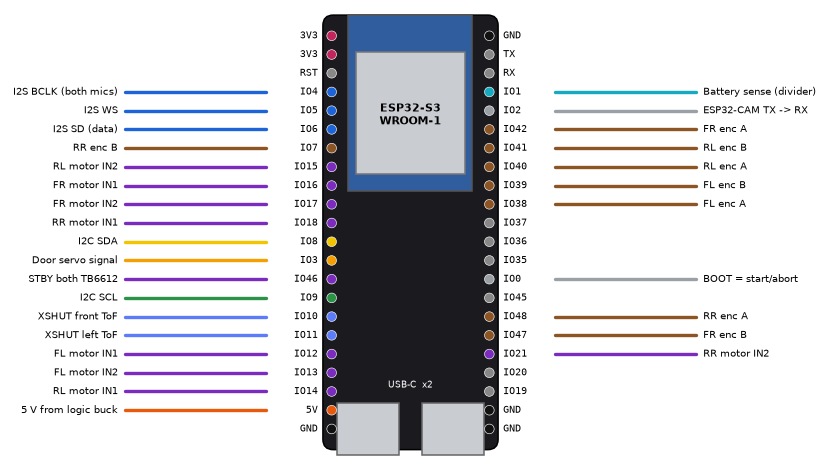
team_share/deck_assets/wiring_guide_crop.png
