yatharth1011/aegis-rescue-rover/team_share/firmware/aegis_s3/sim/results/example_nominal_trace.csv

t | x | y | th | ex | ey | state | v | w | tof_f | tof_l | tof_r | doa_ok | doa_world | obj_x | obj_y | grasped
0.00 | 0.3500 | 0.3500 | 2.2581 | 0.3500 | 0.3500 | 0 | 0.000 | 0.000 | 2.000 | 2.000 | 2.000 | 0 | 2.2580 | 2.6198 | 1.4506 | 0
0.10 | 0.3500 | 0.3500 | 2.2578 | 0.3500 | 0.3500 | 0 | 0.000 | 0.000 | 0.349 | 0.308 | 1.852 | 0 | 2.2580 | 2.6198 | 1.4506 | 0
0.20 | 0.3500 | 0.3500 | 2.2576 | 0.3500 | 0.3500 | 0 | 0.000 | 0.000 | 0.356 | 0.305 | 1.857 | 0 | 2.2580 | 2.6198 | 1.4506 | 0
0.30 | 0.3500 | 0.3500 | 2.2576 | 0.3500 | 0.3500 | 0 | 0.000 | 0.000 | 0.341 | 0.303 | 1.827 | 0 | 2.2580 | 2.6198 | 1.4506 | 0
0.40 | 0.3500 | 0.3500 | 2.2577 | 0.3500 | 0.3500 | 0 | 0.000 | 0.000 | 0.353 | 0.313 | 1.874 | 0 | 2.2580 | 2.6198 | 1.4506 | 0
0.50 | 0.3500 | 0.3500 | 2.2575 | 0.3500 | 0.3500 | 2 | 0.000 | 0.000 | 0.355 | 0.293 | 1.899 | 0 | 2.2580 | 2.6198 | 1.4506 | 0
0.60 | 0.3500 | 0.3500 | 2.2574 | 0.3500 | 0.3500 | 2 | 0.000 | 0.000 | 0.352 | 0.293 | 1.852 | 0 | 2.2580 | 2.6198 | 1.4506 | 0
0.70 | 0.3500 | 0.3500 | 2.2574 | 0.3500 | 0.3500 | 2 | 0.000 | 0.000 | 0.352 | 0.305 | 1.826 | 0 | 2.2580 | 2.6198 | 1.4506 | 0
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
