yatharth1011/aegis-rescue-rover/team_share/firmware/aegis_s3/sim/results/example_nominal_world.csv

kind | a | b | c | d
room | 4 | 3 | 0 | 0
start | 0.35 | 0.35 | 2.25803 | 0
target | 2.61981 | 1.45058 | 0 | 0
box | 1.65066 | 0.0916899 | 1.80413 | 0.610426
box | 0.336221 | 1.92617 | 0.786824 | 2.26775
box | 0.470005 | 1.86437 | 0.938856 | 2.32648
box | 2.41508 | 0.339832 | 2.77174 | 0.681358
box | 0.683002 | 2.14931 | 0.944615 | 2.34114
box | 1.18082 | 1.8729 | 1.67583 | 2.16126
