yatharth1011/aegis-rescue-rover/team_share/firmware/aegis_s3/sim/results/harsh.csv

scenario | run | outcome | t_end | t_first_seen | t_grasp | collisions | min_clear | path_len | home_err | odom_err | cbf_ticks | doa_n | doa_err_deg | doa_err_folded_deg | decisions | table_decisions | obstacles | escapes
harsh | 0 | timeout | 240.01 | -1.00 | -1.00 | 0 | 0.0581 | 2.106 | 1.752 | 0.059 | 339 | 796 | 25.47 | 20.62 | 149 | 0 | 8 | 0
harsh | 1 | timeout | 240.01 | -1.00 | -1.00 | 0 | 0.0274 | 4.065 | 0.650 | 0.038 | 966 | 798 | 21.71 | 14.11 | 153 | 0 | 8 | 0
harsh | 2 | timeout | 240.01 | 19.25 | -1.00 | 2 | 0.0000 | 1.937 | 1.535 | 0.251 | 409 | 5425 | 4.26 | 4.26 | 9 | 0 | 8 | 2
harsh | 3 | timeout | 240.01 | -1.00 | -1.00 | 0 | 0.0276 | 1.256 | 0.221 | 0.007 | 708 | 765 | 45.07 | 43.60 | 135 | 0 | 8 | 0
harsh | 4 | success | 53.27 | 33.11 | 40.71 | 0 | 0.0557 | 6.441 | 0.109 | 0.022 | 333 | 132 | 29.92 | 6.84 | 22 | 0 | 8 | 0
harsh | 5 | success | 33.85 | 14.14 | 22.16 | 0 | 0.0577 | 5.397 | 0.216 | 0.086 | 253 | 59 | 40.69 | 12.50 | 10 | 0 | 8 | 0
harsh | 6 | timeout | 240.01 | 39.13 | -1.00 | 1 | 0.0000 | 3.468 | 2.776 | 0.106 | 313 | 4980 | 5.61 | 5.28 | 26 | 0 | 7 | 1
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
