yatharth1011/aegis-rescue-rover/team_share/firmware/aegis_s3/sim/results/no_audio.csv

scenario | run | outcome | t_end | t_first_seen | t_grasp | collisions | min_clear | path_len | home_err | odom_err | cbf_ticks | doa_n | doa_err_deg | doa_err_folded_deg | decisions | table_decisions | obstacles | escapes
no_audio | 0 | timeout | 240.01 | -1.00 | -1.00 | 1 | 0.0000 | 20.598 | 2.348 | 0.178 | 1977 | 111 | 93.74 | 56.98 | 157 | 0 | 5 | 1
no_audio | 1 | success | 35.11 | 14.35 | 22.23 | 0 | 0.0581 | 6.072 | 0.215 | 0.085 | 301 | 8 | 70.38 | 67.39 | 10 | 0 | 5 | 0
no_audio | 2 | timeout | 240.01 | -1.00 | -1.00 | 3 | 0.0000 | 10.901 | 2.970 | 0.343 | 1362 | 141 | 70.36 | 59.06 | 146 | 0 | 5 | 2
no_audio | 3 | timeout | 240.01 | -1.00 | -1.00 | 0 | 0.0203 | 8.161 | 1.144 | 0.025 | 934 | 121 | 95.47 | 60.31 | 142 | 0 | 5 | 0
no_audio | 4 | success | 62.71 | 37.45 | 44.77 | 1 | 0.0000 | 9.342 | 0.165 | 0.100 | 58 | 17 | 79.66 | 58.26 | 26 | 0 | 5 | 1
no_audio | 5 | success | 30.80 | 14.91 | 19.71 | 0 | 0.0570 | 4.881 | 0.058 | 0.080 | 298 | 8 | 63.04 | 63.04 | 10 | 0 | 5 | 0
no_audio | 6 | success | 146.43 | 120.82 | 128.77 | 1 | 0.0000 | 12.649 | 0.044 | 0.086 | 528 | 52 | 106.44 | 64.59 | 76 | 0 | 4 | 1
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
