yatharth1011/aegis-rescue-rover/team_share/firmware/aegis_s3/sim/results/nominal.csv

scenario | run | outcome | t_end | t_first_seen | t_grasp | collisions | min_clear | path_len | home_err | odom_err | cbf_ticks | doa_n | doa_err_deg | doa_err_folded_deg | decisions | table_decisions | obstacles | escapes
nominal | 0 | success | 36.01 | 17.78 | 25.52 | 0 | 0.0579 | 4.685 | 0.158 | 0.029 | 270 | 87 | 16.66 | 2.55 | 12 | 0 | 5 | 0
nominal | 1 | success | 45.64 | 24.78 | 32.80 | 0 | 0.0581 | 6.074 | 0.193 | 0.063 | 289 | 116 | 17.14 | 6.57 | 16 | 0 | 5 | 0
nominal | 2 | success | 31.44 | 12.74 | 20.69 | 0 | 0.0587 | 4.828 | 0.167 | 0.037 | 261 | 82 | 25.51 | 6.12 | 9 | 0 | 5 | 0
nominal | 3 | timeout | 240.01 | -1.00 | -1.00 | 0 | 0.0447 | 1.820 | 1.108 | 0.039 | 399 | 764 | 22.95 | 13.03 | 136 | 0 | 5 | 0
nominal | 4 | success | 27.25 | 10.50 | 18.31 | 0 | 0.1968 | 3.872 | 0.123 | 0.022 | 0 | 62 | 38.96 | 5.89 | 8 | 0 | 5 | 0
nominal | 5 | success | 29.54 | 11.34 | 19.71 | 0 | 0.0570 | 4.188 | 0.079 | 0.058 | 287 | 102 | 26.29 | 4.86 | 7 | 0 | 5 | 0
nominal | 6 | success | 55.45 | 31.71 | 39.66 | 0 | 0.0148 | 7.776 | 0.140 | 0.010 | 289 | 111 | 22.58 | 10.84 | 21 | 0 | 4 | 0
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
