yatharth1011/aegis-rescue-rover/team_share/firmware/aegis_s3/sim/results/qtable_harsh.csv

scenario | run | outcome | t_end | t_first_seen | t_grasp | collisions | min_clear | path_len | home_err | odom_err | cbf_ticks | doa_n | doa_err_deg | doa_err_folded_deg | decisions | table_decisions | obstacles | escapes
harsh | 0 | success | 50.36 | 29.19 | 35.18 | 0 | 0.0259 | 8.368 | 0.078 | 0.059 | 94 | 74 | 51.71 | 22.60 | 23 | 22 | 8 | 0
harsh | 1 | timeout | 240.01 | -1.00 | -1.00 | 1 | 0.0000 | 8.641 | 3.651 | 0.842 | 2051 | 820 | 66.99 | 32.96 | 151 | 138 | 8 | 1
harsh | 2 | timeout | 240.01 | 134.19 | 140.32 | 33 | 0.0000 | 14.377 | 1.879 | 1.473 | 10517 | 2381 | 15.18 | 13.60 | 81 | 79 | 8 | 3
harsh | 3 | timeout | 240.01 | -1.00 | -1.00 | 1 | 0.0000 | 11.278 | 2.638 | 0.096 | 874 | 624 | 27.07 | 12.97 | 146 | 144 | 8 | 1
harsh | 4 | success | 38.22 | 17.57 | 24.82 | 0 | 0.0596 | 6.424 | 0.118 | 0.016 | 215 | 70 | 20.05 | 4.47 | 13 | 13 | 8 | 0
harsh | 5 | success | 49.33 | 31.29 | 36.65 | 0 | 0.0213 | 5.952 | 0.228 | 0.122 | 804 | 166 | 25.53 | 11.23 | 19 | 19 | 8 | 0
harsh | 6 | timeout | 240.01 | -1.00 | -1.00 | 3 | 0.0000 | 10.658 | 3.360 | 0.438 | 1072 | 737 | 26.10 | 10.98 | 147 | 145 | 7 | 3
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
