yatharth1011/aegis-rescue-rover/team_share/firmware/aegis_s3/sim/results/deck_figure.png

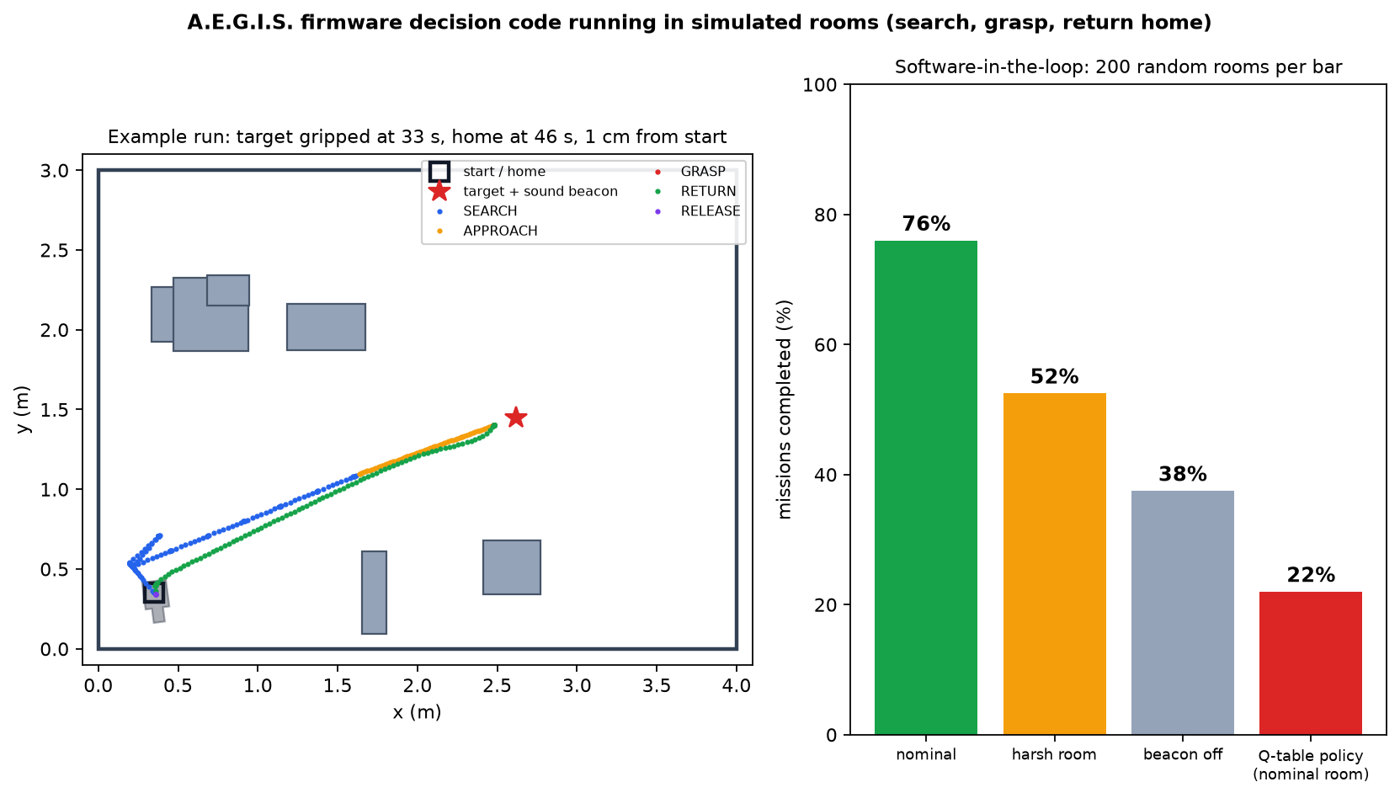
team_share/firmware/aegis_s3/sim/results/deck_figure.png
