yatharth1011/aegis-rescue-rover/team_share/firmware/aegis_s3/sim/results/example_nominal.gif

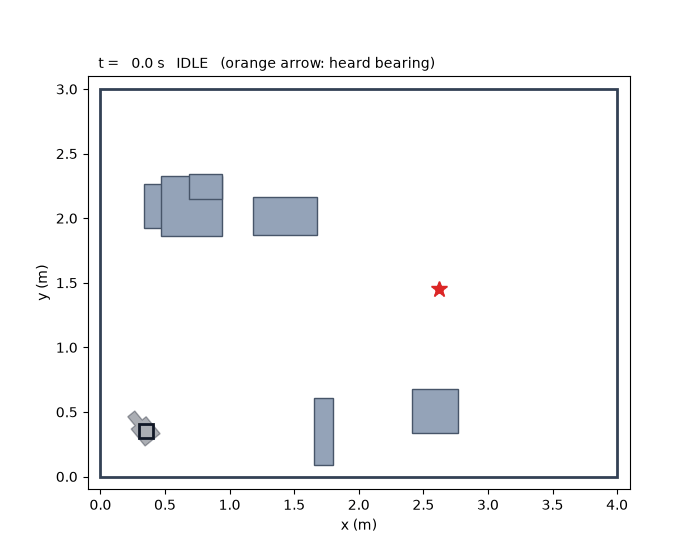
team_share/firmware/aegis_s3/sim/results/example_nominal.gif
