yatharth1011/aegis-rescue-rover/team_share/firmware/aegis_s3/sim/results/summary.png

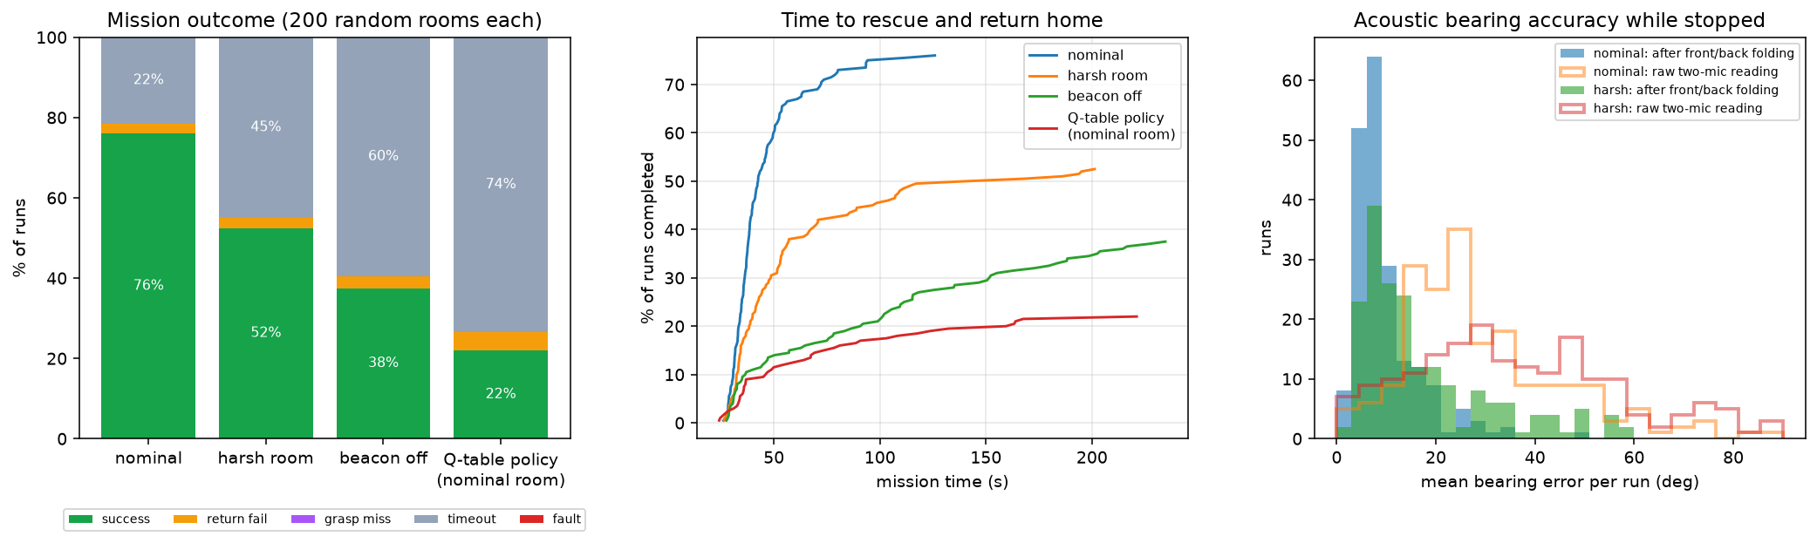
team_share/firmware/aegis_s3/sim/results/summary.png
