yatharth1011/aegis-rescue-rover/team_share/simulation3d/results/example_demo1.gif

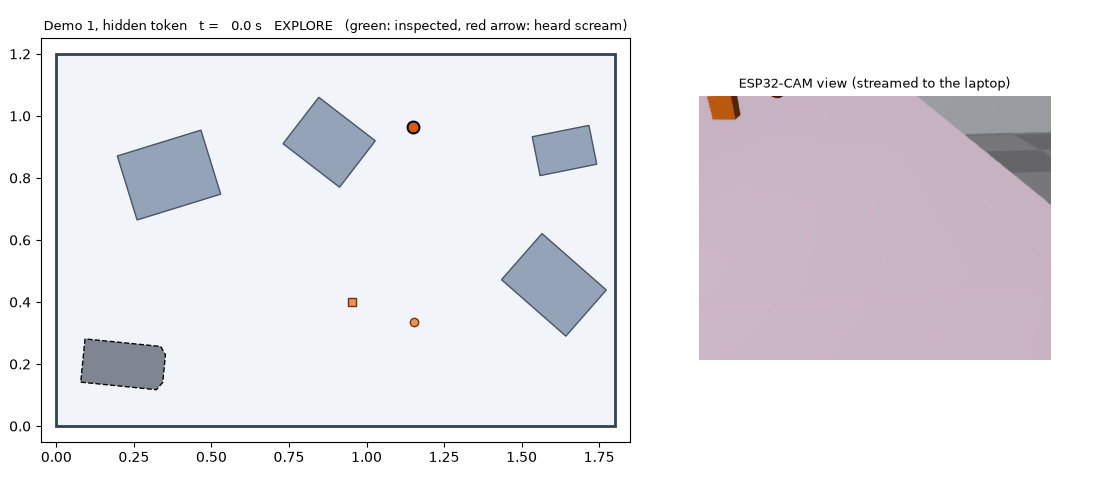
team_share/simulation3d/results/example_demo1.gif
