yatharth1011/aegis-rescue-rover/team_share/simulation3d/results/example_demo2.gif

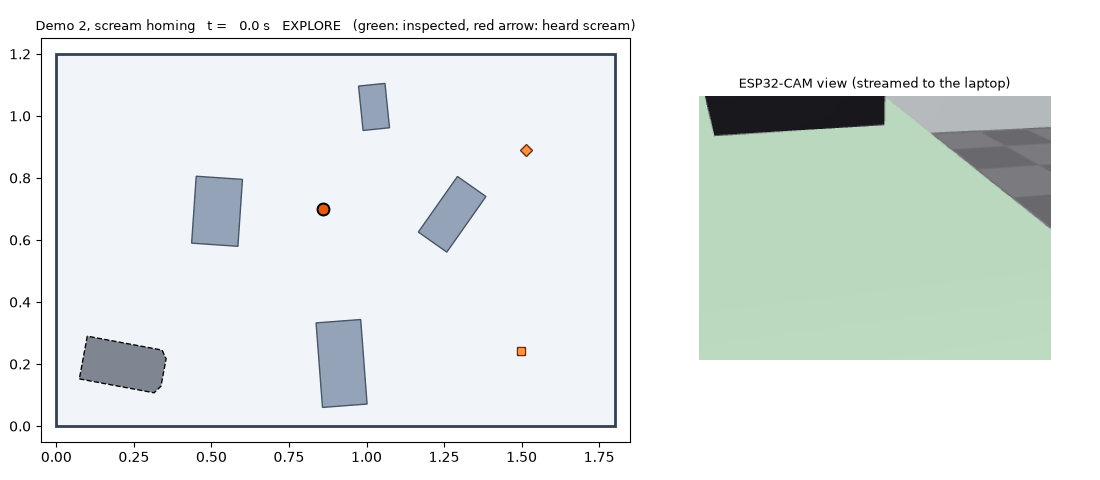
team_share/simulation3d/results/example_demo2.gif
