yatharth1011/aegis-rescue-rover/team_share/firmware/aegis_s3/main/drivers/servo.h

/* Gripper servo on LEDC: 50 Hz, 14-bit, pulse width clamped to the safe range. */
#pragma once

#include <stdint.h>

#include "esp_err.h"

esp_err_t servo_init(void);
void servo_write_us(uint32_t us);
