yatharth1011/aegis-rescue-rover/(commit log)

2026-10-24 A.E.G.I.S. rescue rover: TL101 project
    Mk2 Fusion design (printable and detailed, engraved decks, wiring harness),
    ESP32-S3 firmware with host tests and 2D SIL simulator, 3D MuJoCo simulation
    with YOLO detector, room acoustics and Wi-Fi model, engineering calculations,
    wiring guide, and the submission deck, BOM and approval form.
2026-10-24 Name submission files to the course format (AEGIS, Thursday, slot 1)
    ProjectIdea_AEGIS_Thursday_1.pptx, ItemList_AEGIS_Thursday_1.xlsx,
    ApprovalForm_AEGIS_Thursday_1.docx; form lab session set to Thursday
    2-4 PM; generators updated to write the new names. Adds the re-run
    scream batch results (final_demo2_v2.csv).
2026-10-24 Fix table-edge falls: rear-corner cliff sensors, wider edge margin, no-turn reflex
    Falls drop from 2 in 40 scream runs to 1 in 120 missions; hidden-token success
    70% (was 80%) because the rover is now more cautious near edges. Re-ran all
    four batches, regenerated report, GIFs, deck (15 slides), form and BOM
    (Rs 11,183). Fusion model and wiring guide add the two new sensors.
2026-10-25 Add wiring, power switch, fuse and carrier board to the item list, wiring guide and Fusion model
    Item list grows to 35 lines (Rs 11,971, reserve Rs 3,029). Battery lead is the pack's
    T-connector; battery divider is now 100k/20k to match the resistor kit (firmware updated,
    build clean, 32/32 host tests pass). ESP32-S3 moves onto a prototype-board carrier at
    x = -63 mm so the wire slot stays clear; rocker switch cut into the upper deck.
2026-10-25 Printable-part fixes and print-ready 3MF
    Motor hangers get cable-tie channels so the motors cannot drop out; camera mast gets
    M3 bolt holes (matching upper-deck holes) and a 30-degree camera pad; funnel fin is
    full height and the door hub has a 45-degree cone, so every part prints without
    supports. tools/make_3mf.py writes team_share/print/AEGIS_PLA_parts.3mf with the
    seven rover parts and the demo props.
2026-10-25 3MF: lay out plates for the Creality K1 Max bed
2026-10-25 Final item list with consumables; fix the three Fusion clashes; one 3MF per K1 Max plate
    Adds cable ties, solder, foam tape and orange PLA so nothing depends on lab consumables
    (Rs 13,476, reserve Rs 1,524). Switch cutout corners r0.5, shroud clearance for the FR
    cliff sensor, door hub cone joined to the door body. 3MF split into black and orange
    plates, centred on the 300 x 300 bed.
2026-10-25 3MF: add three VL53L0X L-brackets
2026-10-25 LaserCAD-ready deck DXFs: R12, red cut / blue engrave layers, splines flattened
2026-10-25 Fabrication guide: which file is cut or printed from which material
2026-10-25 Regenerate model outputs, LaserCAD DXFs and 3MF plates from the clash-free Fusion build
2026-10-25 Detailed build: take the wiring views after the archive export so the upper deck is never saved hidden; FINAL uses the saved detailed model until the next rerun
2026-10-25 Motor mount: 1 mm corner fillets and 0.5 mm chamfers on the screw holes
2026-10-25 Revert "Motor mount: 1 mm corner fillets and 0.5 mm chamfers on the screw holes"
    This reverts commit 8c71a527f345d91e981303fd7317334a65fcd8fc.
2026-10-26 Deployable system: rover Wi-Fi link and edge reflex, ESP32-CAM firmware, laptop edge brain, assembly guide
    ESP32-S3: PCF8574 edge/bay sensors, table-edge reflex and stall escape in the portable core
    (same rules as the 3D simulation, 41/41 host tests), edge mode with a 300 ms link watchdog,
    UDP telemetry and audio clips, door servo, Mk2 CBF distance; 1.5 MB app partition.
    ESP32-CAM: MJPEG stream and discovery beacon. Laptop: aegis_edge.py runs brain.py on the
    real link with pose-history frame timing and the ArUco start-pad fix; bringup.py dashboard;
    fake_rover.py and test_end_to_end.py for hardware-free tests; start pad, dataset capture,
    camera calibration. Assembly guide rendered from the ST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
2026-10-26 Assembly guide rebuilt: 27 one-action steps, CAD-style lines, RESULT views, kit-only fasteners; PDF fabrication and deployment guides
    Fasteners now come only from the M3 kit (it has no M3x10): M3x6 self-tapping into 2.5 mm pilots
    (shroud flanges and mast base changed in Fusion and the 3MF), pillar studs with nuts, cable ties on the
    servo ears. Guide outlines are drawn from the geometry's sharp edges with depth-tested visibility.
    End-to-end real-time test against the fake rover: 9/16 missions, 0 falls.
2026-10-26 Step-by-step wiring guide (W1-W15) tied to the assembly order
    Bench prep, lower deck at assembly step 16 and upper deck at step 24, each step with its own
    pin-to-pin drawing, a From/To/Wire table generated from the drawing, and a multimeter check.
    Old pin map and board faces kept as an appendix; unused camera UART wire removed.
2026-10-26 Run without measuring the table: learn each edge from the cliff sensors (--table unknown, now the default)
